marcsekz/radartof/hardware/portenta-shared-pins.PNG

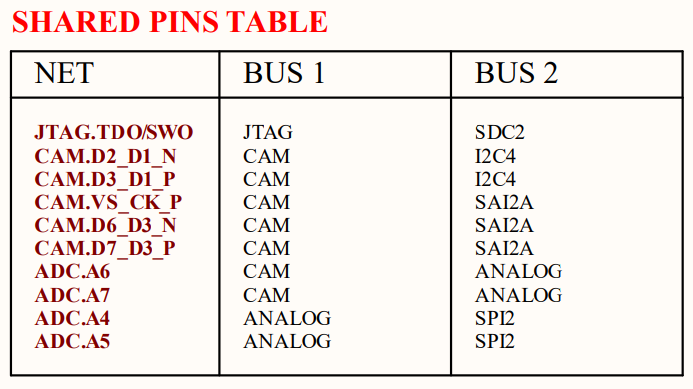
hardware/portenta-shared-pins.PNG
