marcsekz/radartof/hardware/Parts/1140084168/MicroSD.stp

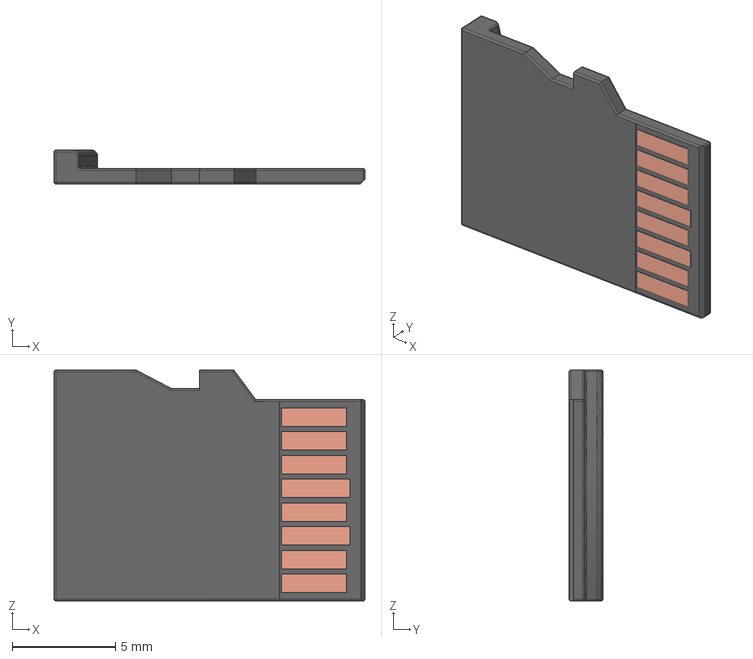
[picture p2: CAD file, 2023-04-24]
hardware/Parts/1140084168/MicroSD.stp
15.1 x 1.65 x 11.2 mm
