marcsekz/radartof/hardware/Parts/ASPI-4030S.STEP

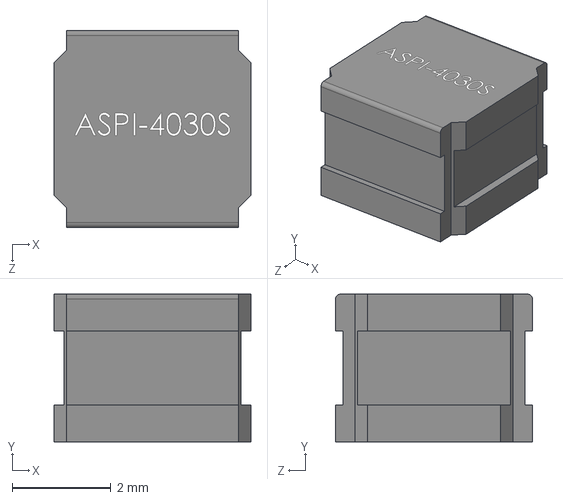
[picture p3: CAD file, 2023-04-24]
hardware/Parts/ASPI-4030S.STEP
4.00 x 3.00 x 4.00 mm
