marcsekz/radartof/hardware/Parts/Portenta/DF40HC(3.5)-80DS.stp

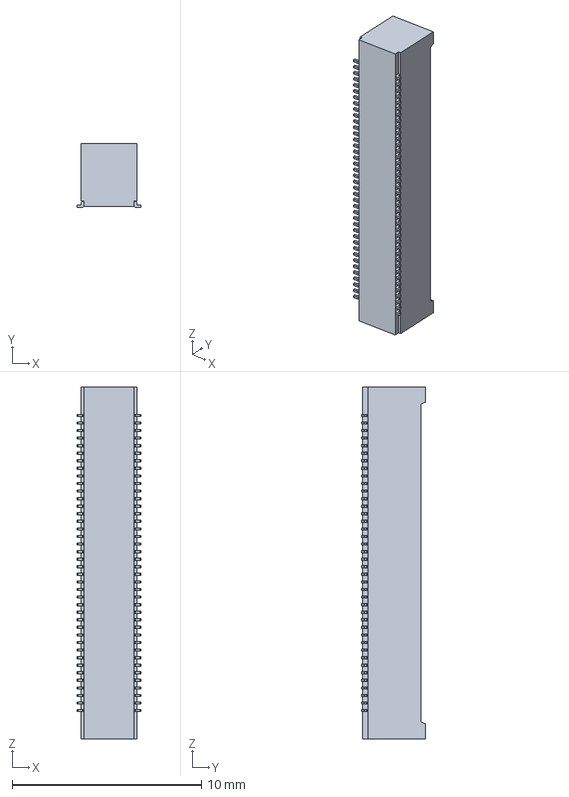
[picture p4: CAD file, 2023-04-14]
hardware/Parts/Portenta/DF40HC(3.5)-80DS.stp
3.38 x 3.40 x 18.6 mm
