marcsekz/radartof/hardware/Parts/PTS815-SJ/PTS815SJM250SMTRLFS.stp

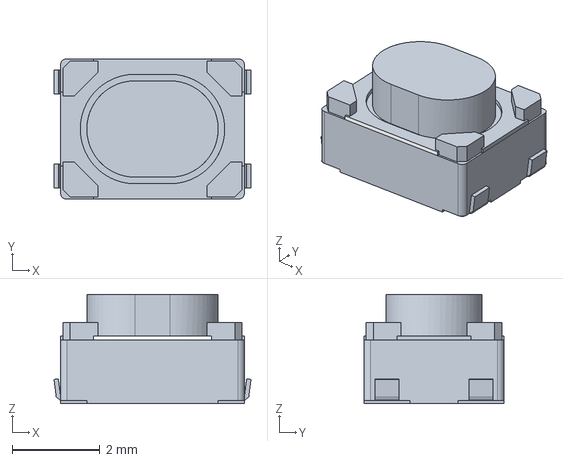
[picture p5: CAD file, 2023-04-24]
hardware/Parts/PTS815-SJ/PTS815SJM250SMTRLFS.stp
4.50 x 3.20 x 2.50 mm
