marcsekz/radartof/hardware/Parts/VL53L5CX/VL53L5CX_3D_model.step

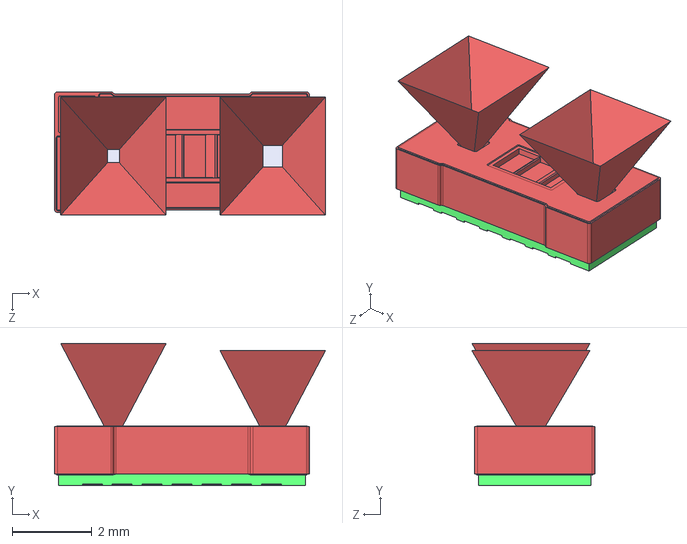
[picture p6: CAD file, 2023-04-24]
hardware/Parts/VL53L5CX/VL53L5CX_3D_model.step
6.81 x 3.57 x 3.10 mm
