marcsekz/radartof/hardware/Parts/PTS815-SJ/Download_STP_4341x30258x6 (rev1).stp

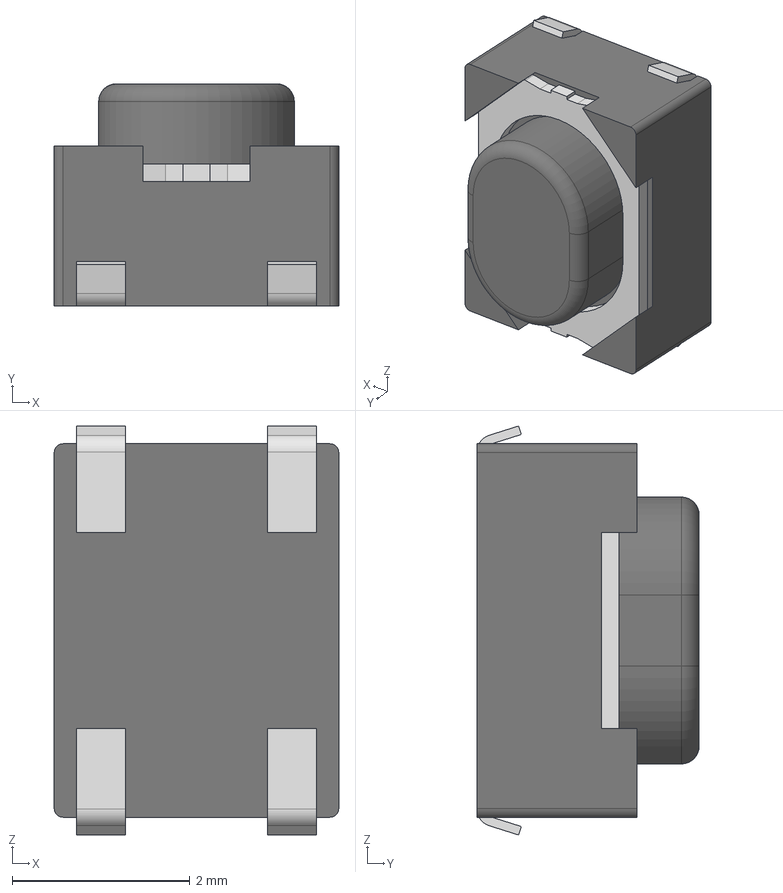
[picture p7: CAD file, 2023-04-24]
hardware/Parts/PTS815-SJ/Download_STP_4341x30258x6 (rev1).stp
3.20 x 2.50 x 4.60 mm
Frame
Cover
Stem
Terminal x 4
