marcsekz/radartof/hardware/Parts/216989-0001/2169890001.stp

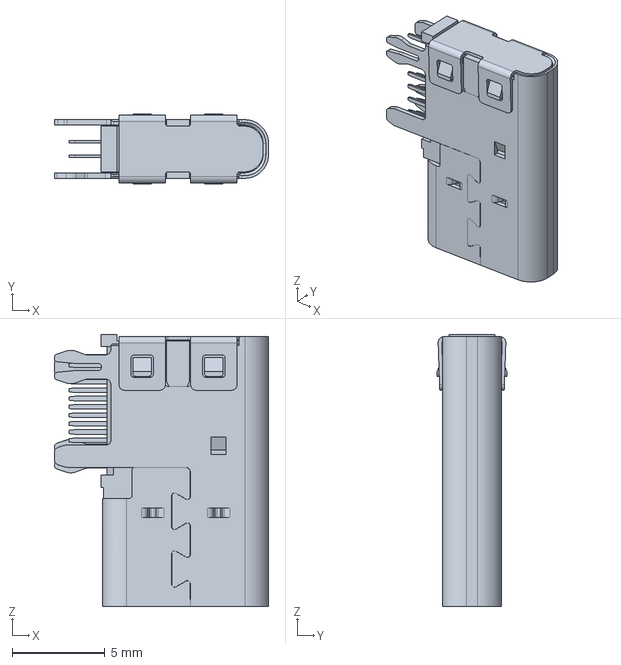
[picture p8: CAD file, 2023-04-24]
hardware/Parts/216989-0001/2169890001.stp
11.5 x 3.76 x 14.7 mm
