marcsekz/radartof/hardware/Parts/OV5640/5051102491.stp

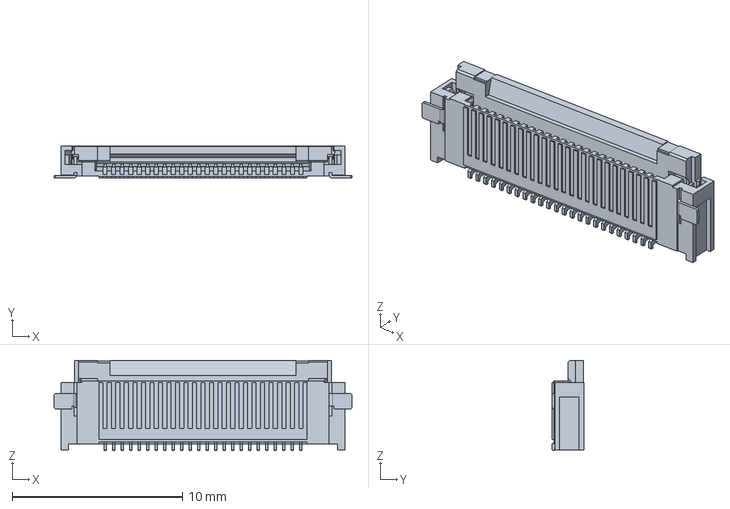
[picture p9: CAD file, 2023-04-24]
hardware/Parts/OV5640/5051102491.stp
17.5 x 1.90 x 5.30 mm
