marcsekz/radartof/hardware/Parts/1140084168/1140084168.step

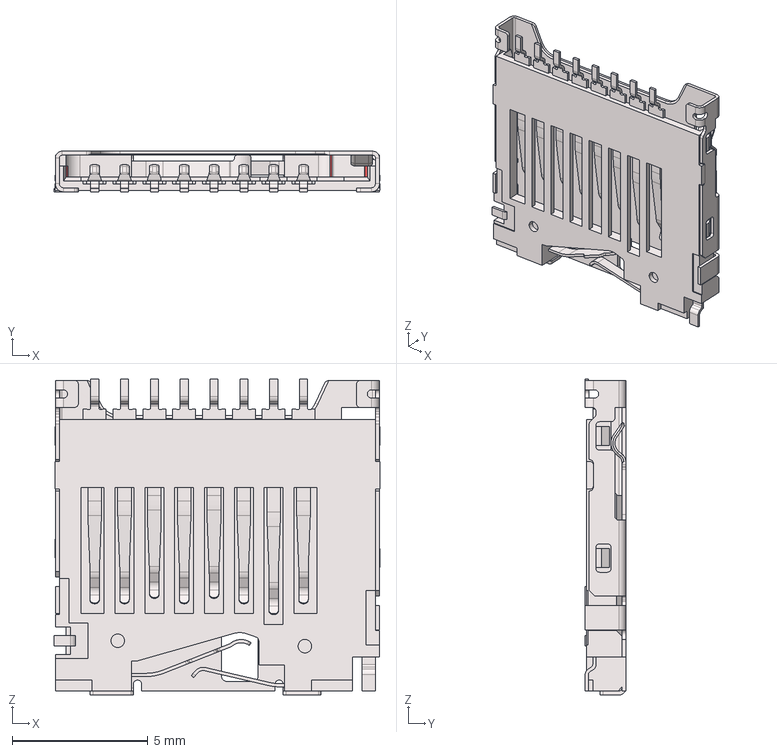
[picture p10: CAD file, 2023-04-24]
hardware/Parts/1140084168/1140084168.step
12.0 x 1.50 x 11.7 mm
