marcsekz/radartof/hardware/radartof-hardware.kicad_pcb.pdf

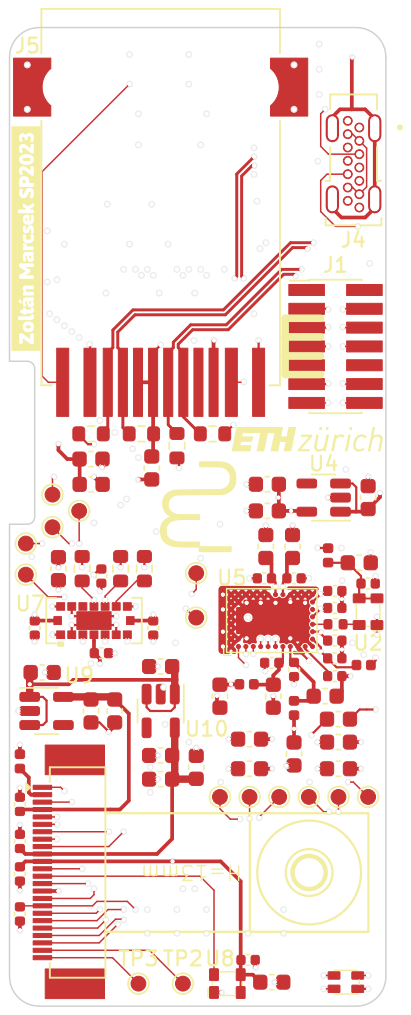
[picture p11: page 1]

Id: 1/1 Title: Heterogeneous radar, RGB, ToF sensor board

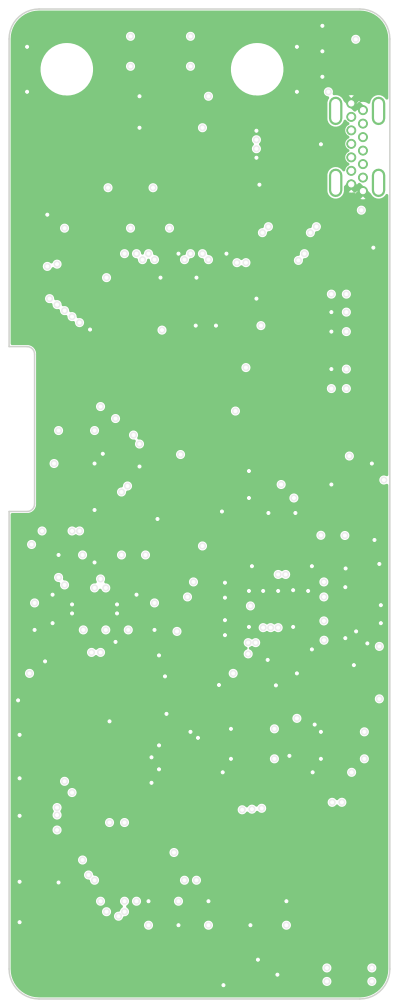
[picture p12: page 2]
D Date: 2023-04-26 KiCad; kicad-cli; 7.0.1-3b83917a11~172~ubuntu20.04.1 Size: A4; Rev:; File: radartof-hardware.kicad_pcb Sheet: Center for; Project-Based; Learning; þÿZoltán Marcsek

Id: 1/1 Title: Heterogeneous radar, RGB, ToF sensor board

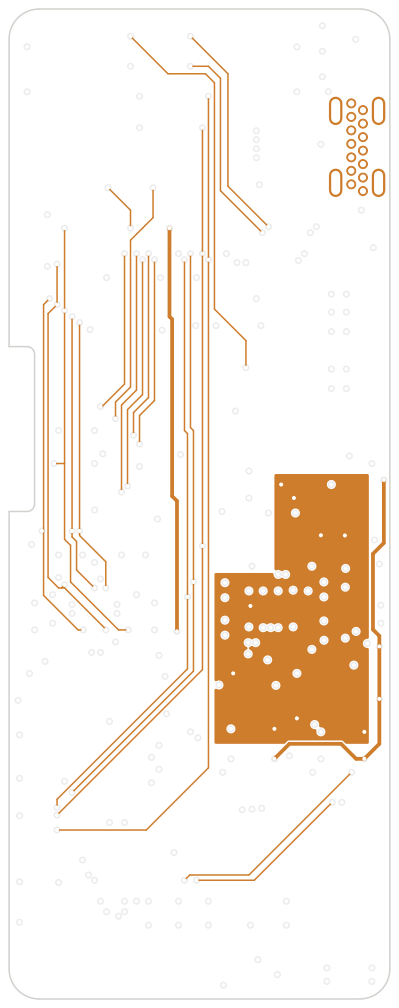
[picture p13: page 3]
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

Id: 1/1 Title: Heterogeneous radar, RGB, ToF sensor board

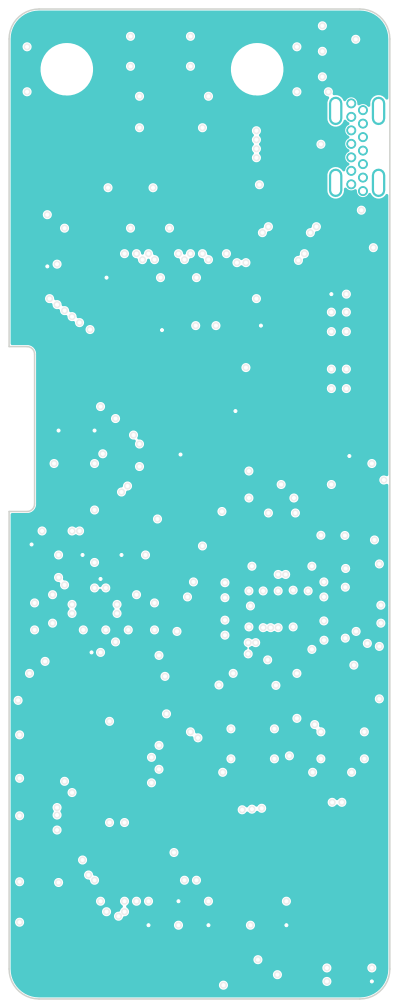
[picture p14: page 4]
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

Id: 1/1 Title: Heterogeneous radar, RGB, ToF sensor board

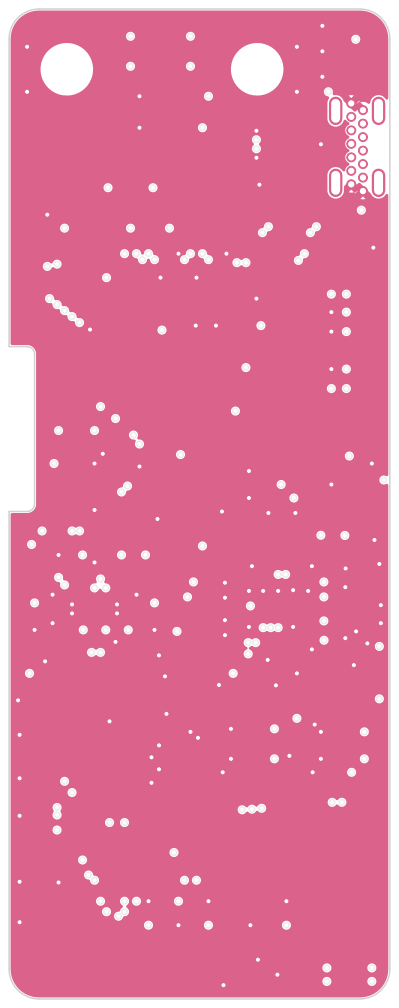
[picture p15: page 5]
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

Id: 1/1 Title: Heterogeneous radar, RGB, ToF sensor board

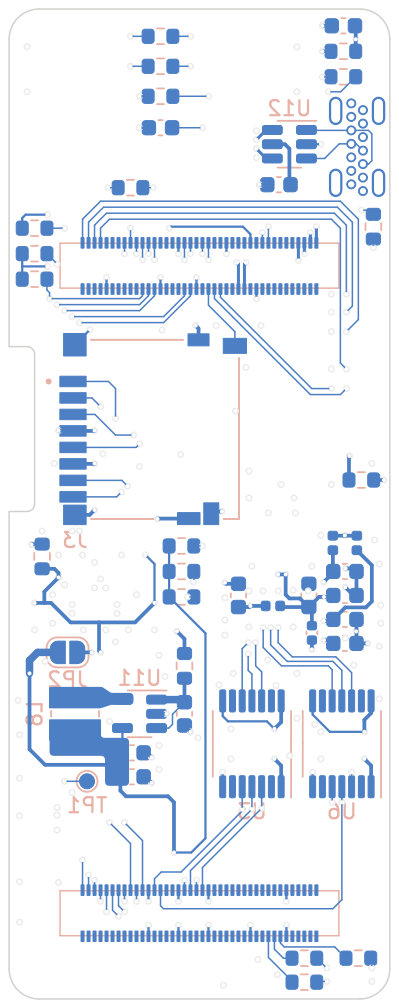
[picture p16: page 6]

Id: 1/1 Title: Heterogeneous radar, RGB, ToF sensor board
