marcsekz/radartof/hardware/radartof-hardware.pdf

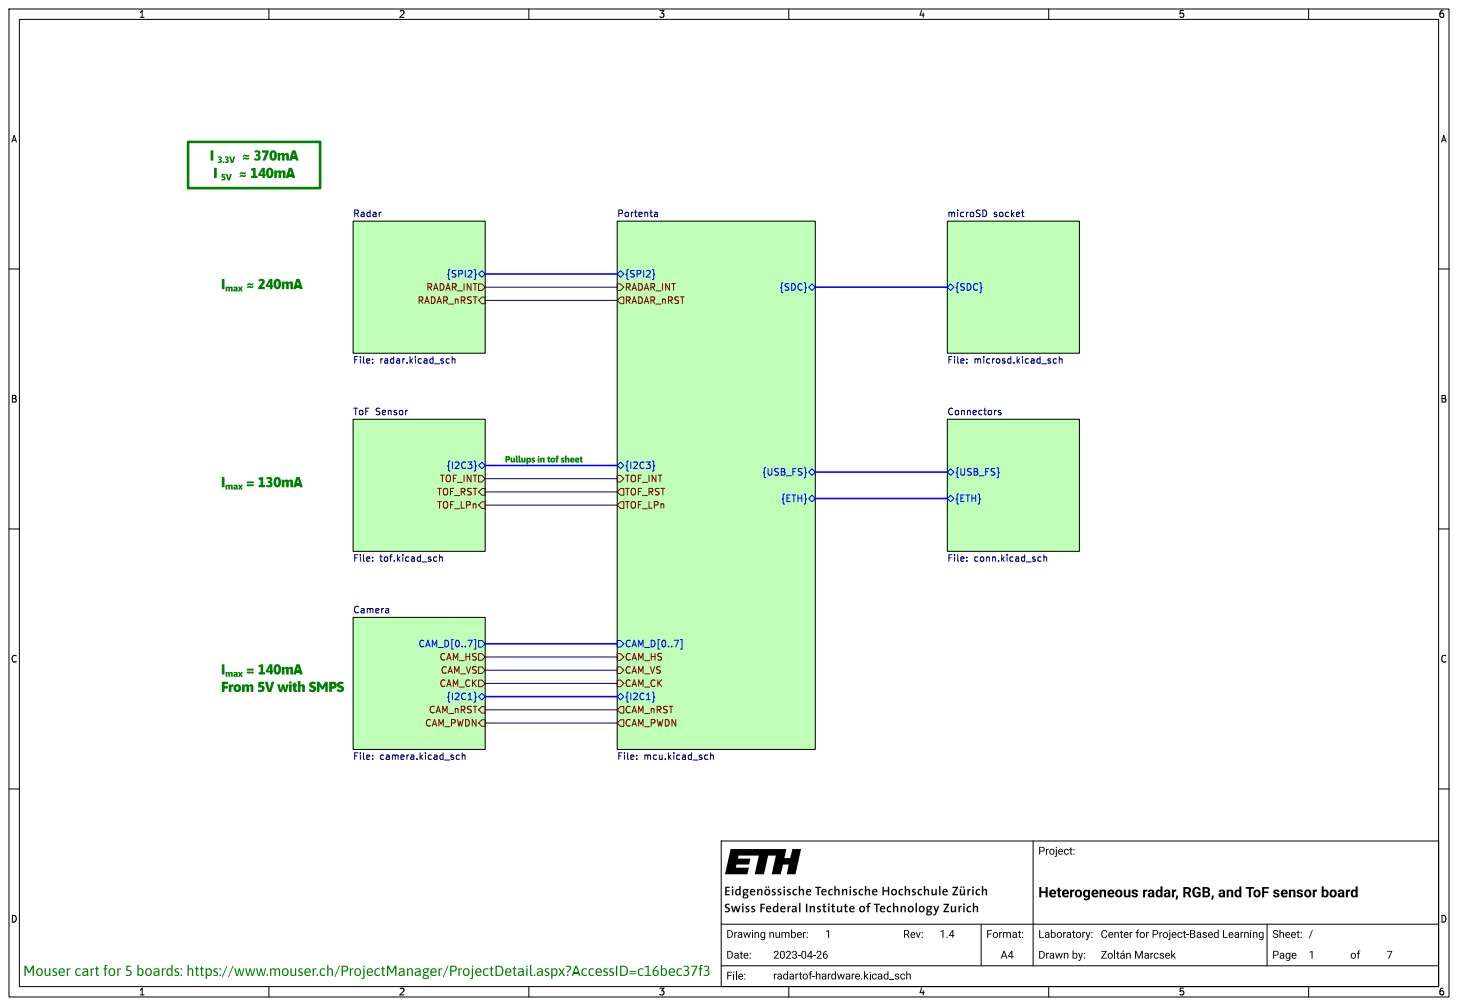
[picture p17: page 1]

{SDC} RADAR_nRST Portenta File: mcu.kicad_sch Pullupsin tof sheet I_{max} = 130mA

{SDC} microSD socket File: microsd.kicad_sch RADAR_INT
{SPI2} TOF_RST CAM_CK CAM_VS CAM_HS CAM_D[0..7] TOF_LPn CAM_PWDN

{I2C3} ToF Sensor File: tof.kicad_sch

Mouser cart for 5 boards:https://www.mouser.ch/ProjectManager/ProjectDetail.aspx?AccessID=c16bec37f3

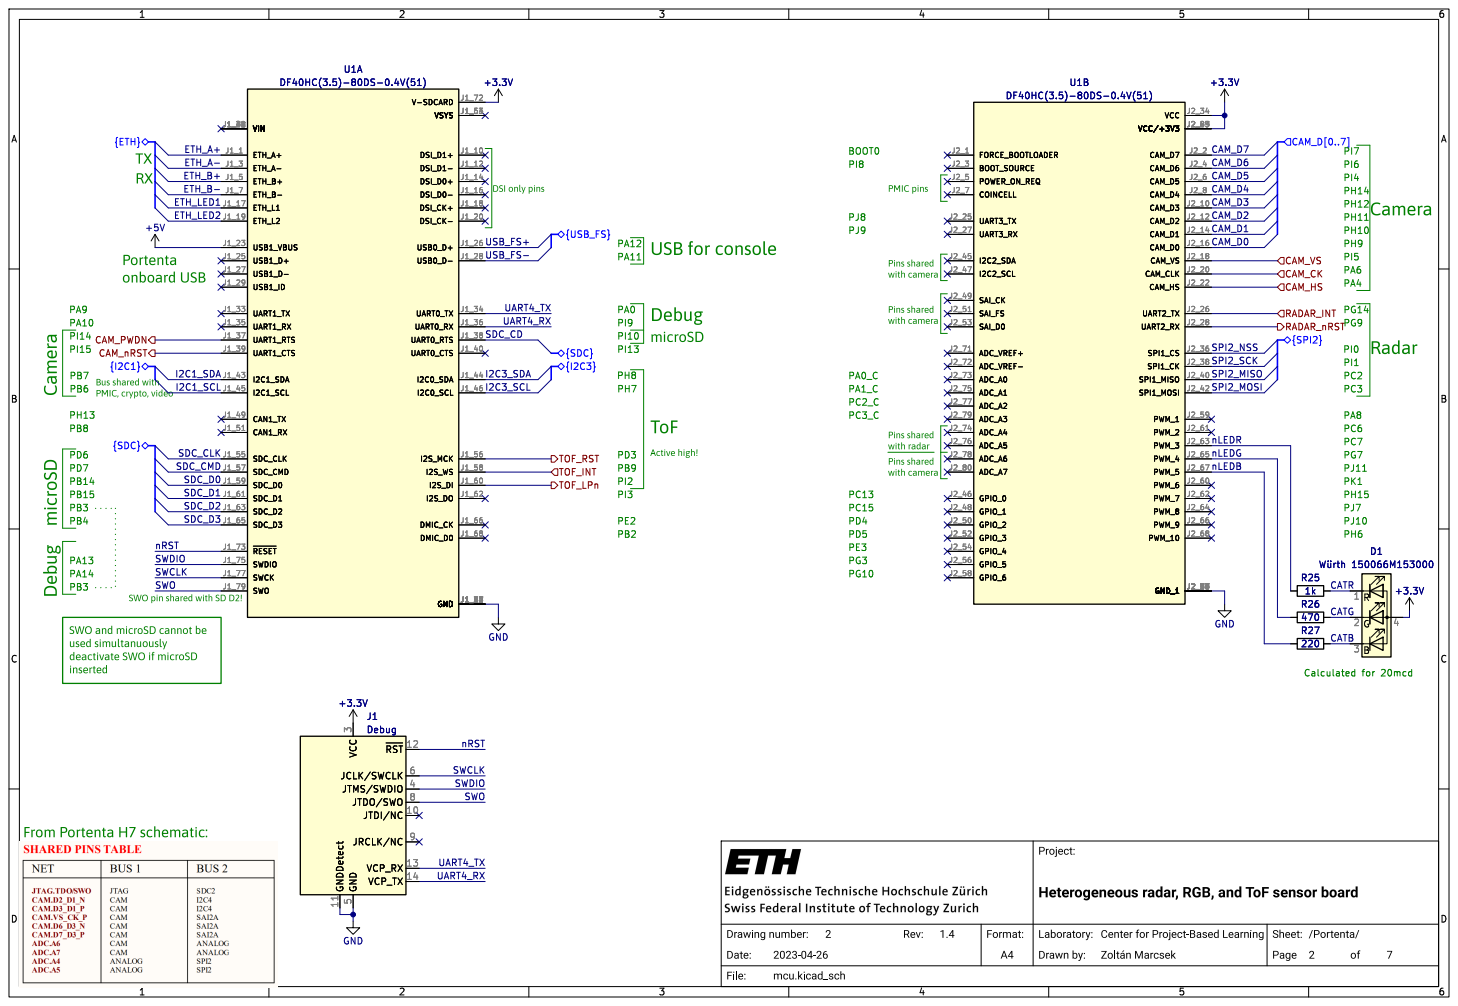
[picture p18: page 2]

used simultanuously deactivate SWOif microSD

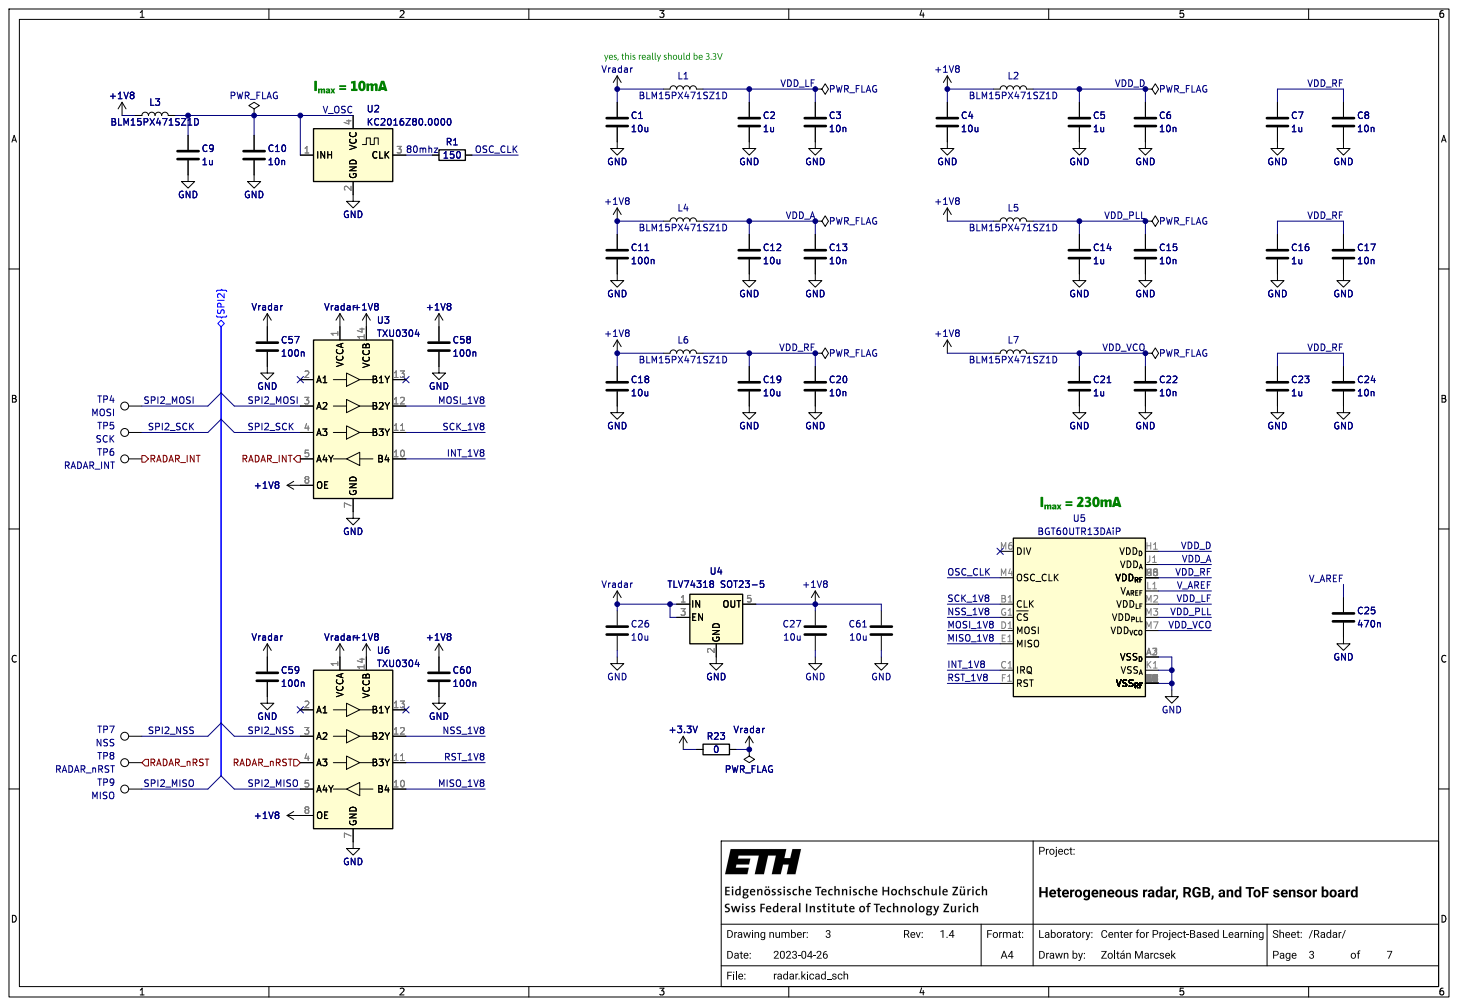
[picture p19: page 3]

yes,this really should be 3.3V

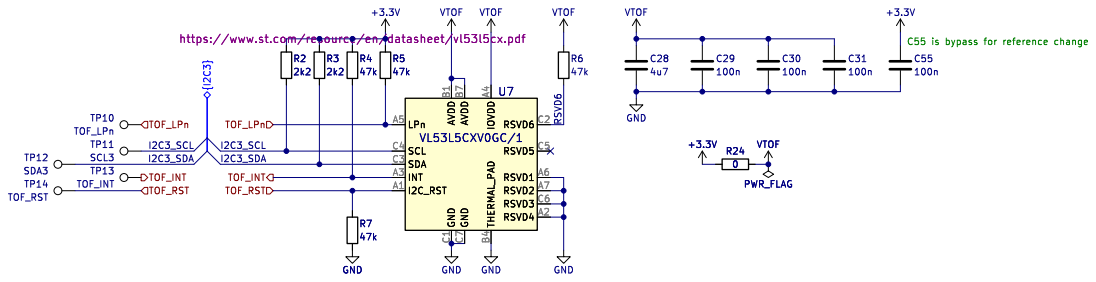
[picture p20: page 4]

https://www.st.com/resource/en/datasheet/vl53l5cx.pdf R2

https://www.st.com/resource/en/datasheet/vl53l5cx.pdf

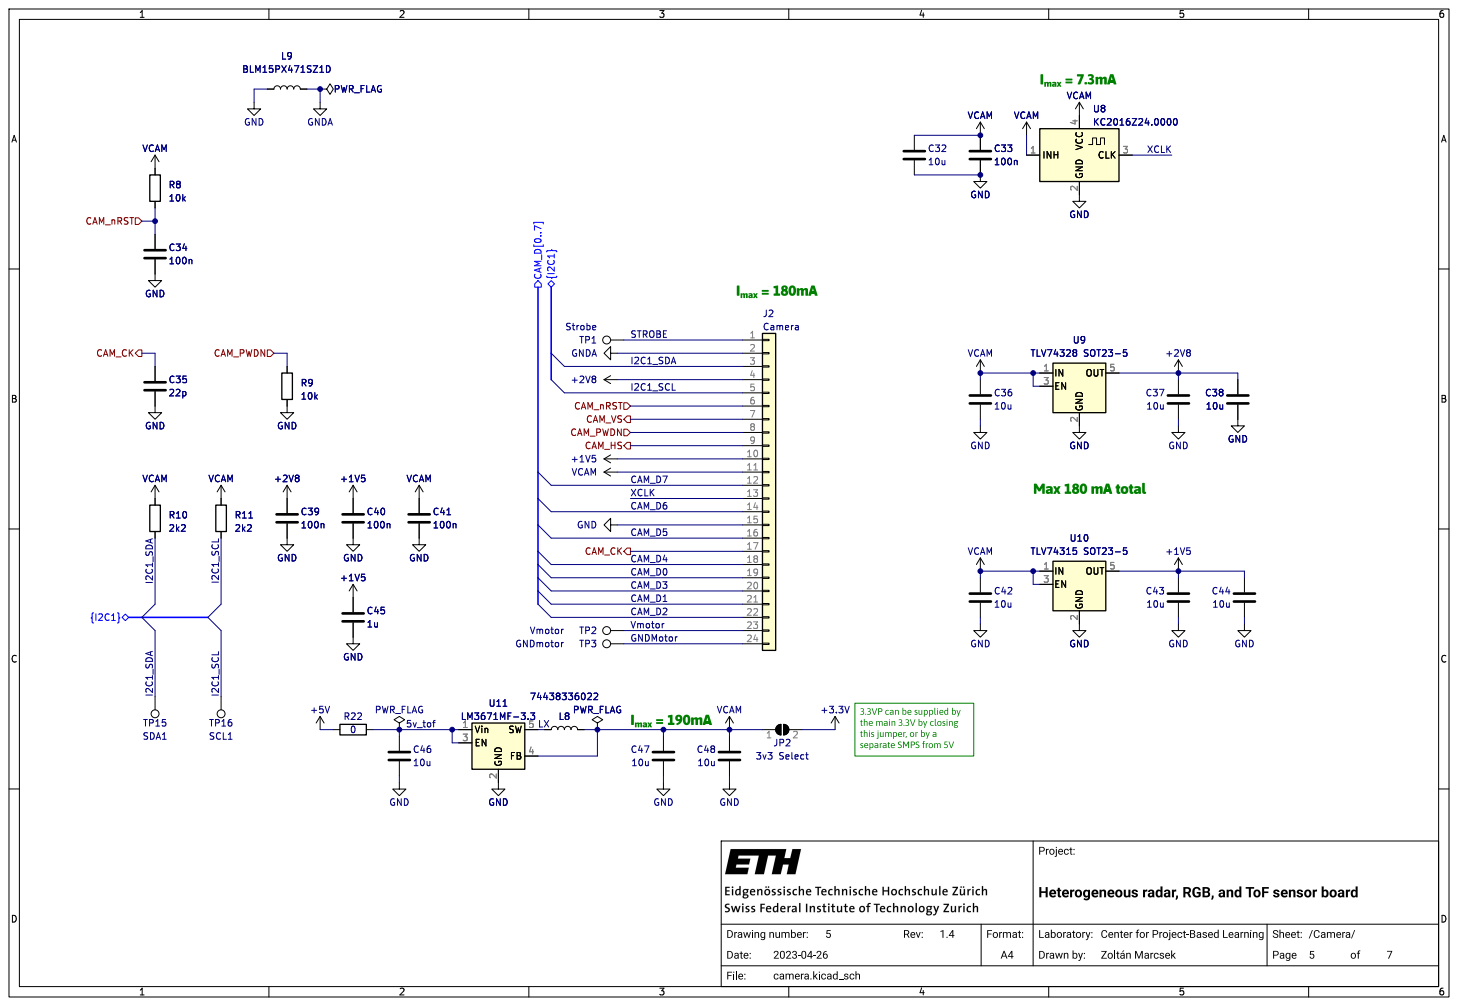
[picture p21: page 5]

3.3VPcan be supplied by
the main 3.3Vby closing
this jumper, or by a

2 EN 3 FB 4 SW 5 GND

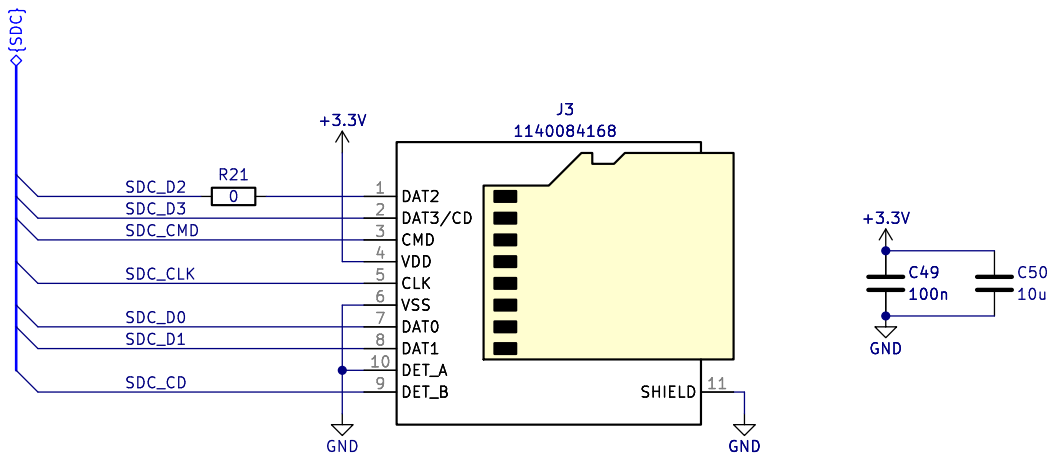
[picture p22: page 6]

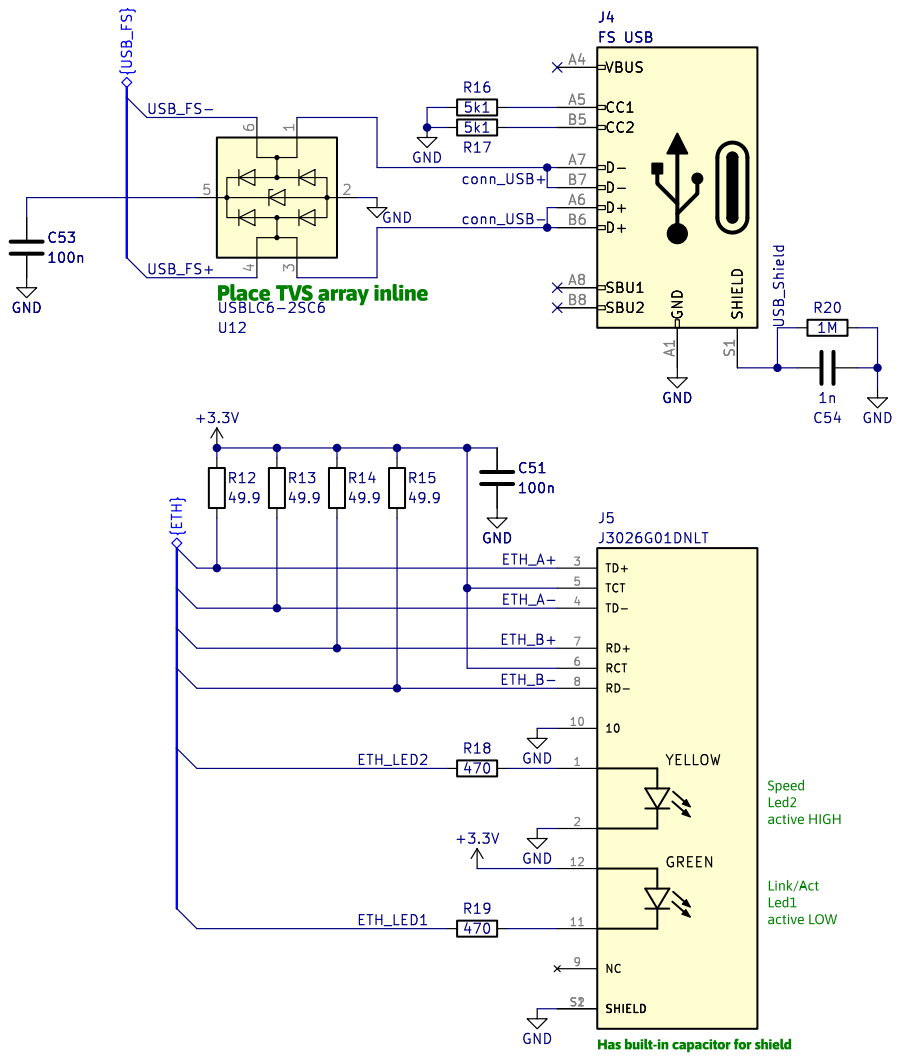
[picture p23: page 7]
