marcsekz/radartof/hardware/radartof-hardware.kicad_pcb

## KiCad design hardware/radartof-hardware.kicad_pcb (2023-06-26)

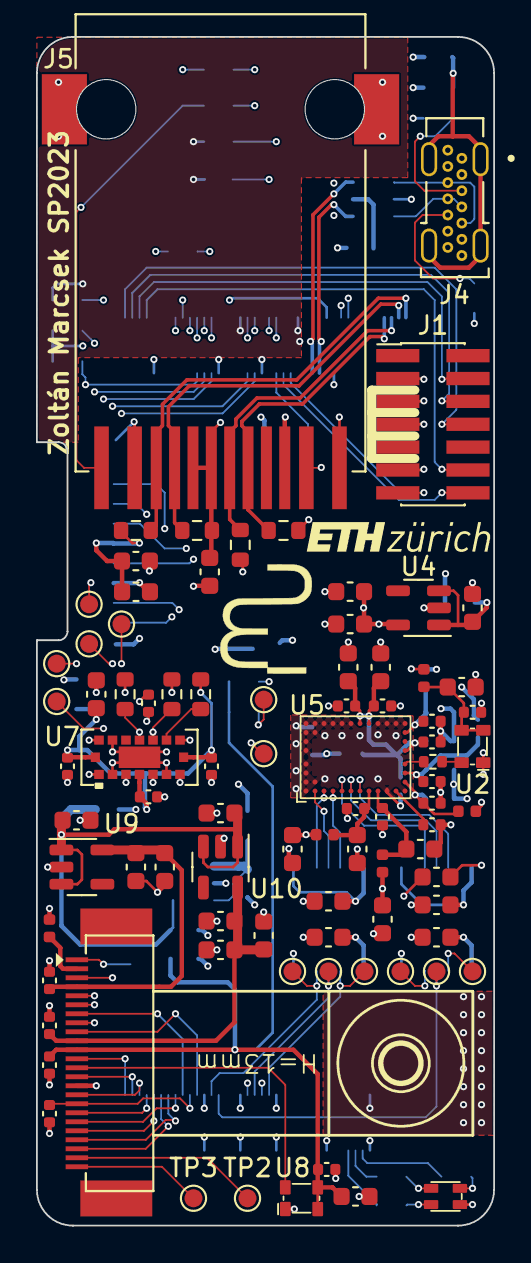
[picture p24: board radartof-hardware.kicad_pcb from above]

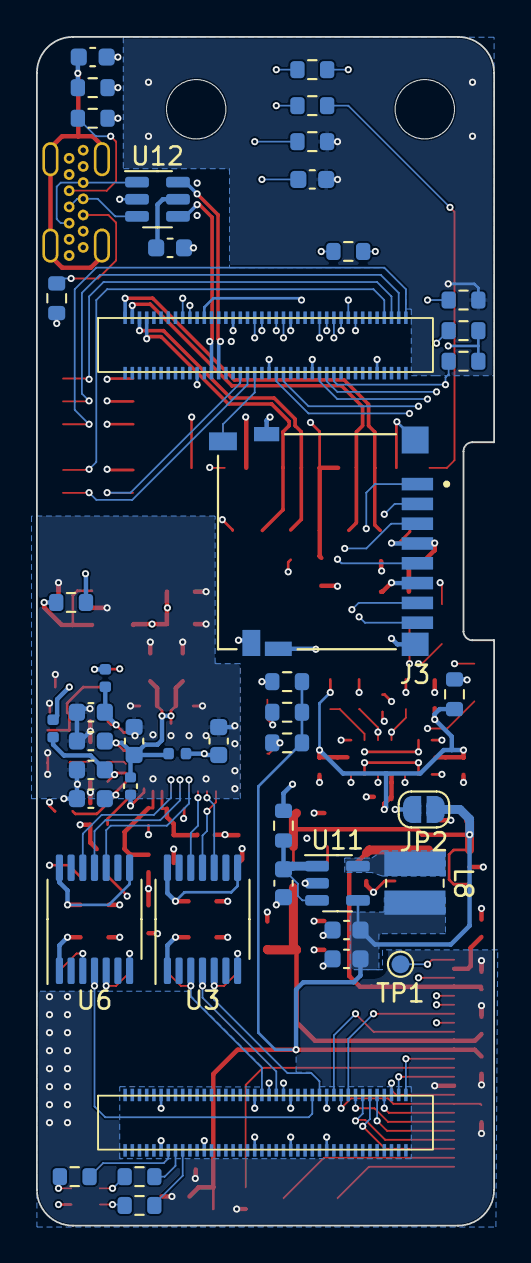
[picture p25: board radartof-hardware.kicad_pcb from below]

Board: 6 copper layers, 25.4 x 66.0 mm, 130 parts (44 on the bottom side), 95 nets.

Parts:
C1, C4, C12, C18, C19, C26, C27, C32, C36, C37, C38, C42, C43, C44, C46, C47, C48, C50, C61: 10u; C_0603_1608Metric
C2, C5, C7, C9, C14, C16, C21, C23, C45: 1u; C_0603_1608Metric
C3, C6, C8, C10, C13, C15, C17, C20, C22, C24: 10n; C_0402_1005Metric
C11, C34, C49, C51, C53, C57, C58, C59, C60: 100n; C_0603_1608Metric
C25: 470n; C_0402_1005Metric
C28: 4u7; C_0603_1608Metric
C29, C30, C31, C33, C39, C40, C41, C55: 100n; C_0402_1005Metric
C35: 22p; C_0402_1005Metric
C54: 1n; C_0603_1608Metric
D1: Würth 150066M153000; Würth_150066M153000
J1: Debug; PinHeader_2x07_P1.27mm_Vertical_SMD
J2: Camera; OV2640FSL
J3: 1140084168; AMPHENOL_1140084168
J4: FS USB; MOLEX_216989-0001
J5: J3026G01DNLT; PE_J3026G01DNLT
JP2: 3v3 Select; SolderJumper-2_P1.3mm_Open_RoundedPad1.0x1.5mm
L1, L2, L3, L4, L5, L6, L7, L9: BLM15PX471SZ1D; L_0402_1005Metric
L8: 74438336022; L_Wuerth_MAPI-3020
R1: 150; R_0402_1005Metric
R2, R3, R10, R11: 2k2; R_0603_1608Metric
R4, R5, R6, R7: 47k; R_0603_1608Metric
R8, R9: 10k; R_0603_1608Metric
R12, R13, R14, R15: 49.9; R_0603_1608Metric
R16, R17: 5k1; R_0603_1608Metric
R18, R19, R26: 470; R_0603_1608Metric
R20: 1M; R_0603_1608Metric
R21, R22, R23, R24: 0; R_0603_1608Metric
R25: 1k; R_0603_1608Metric
R27: 220; R_0603_1608Metric
TP1: Strobe; TestPoint_Pad_D1.0mm
TP2: Vmotor; TestPoint_Pad_D1.0mm
TP3: GNDmotor; TestPoint_Pad_D1.0mm
TP4: MOSI; TestPoint_Pad_D1.0mm
TP5: SCK; TestPoint_Pad_D1.0mm
TP6: RADAR_INT; TestPoint_Pad_D1.0mm
TP7: NSS; TestPoint_Pad_D1.0mm
TP8: RADAR_nRST; TestPoint_Pad_D1.0mm
TP9: MISO; TestPoint_Pad_D1.0mm
TP10: TOF_LPn; TestPoint_Pad_D1.0mm
TP11: SCL3; TestPoint_Pad_D1.0mm
TP12: SDA3; TestPoint_Pad_D1.0mm
TP13: TOF_INT; TestPoint_Pad_D1.0mm
TP14: TOF_RST; TestPoint_Pad_D1.0mm
TP15: SDA1; TestPoint_Pad_D1.0mm
TP16: SCL1; TestPoint_Pad_D1.0mm
U1: DF40HC(3.5)-80DS-0.4V(51); MODULE_ABX00042_NOSCREWS
U2: KC2016Z80.0000; KC2016Z
U3, U6: TXU0304; TSSOP-14_4.4x5mm_P0.65mm
U4: TLV74318 SOT23-5; SOT-23-5
U5: BGT60UTR13DAiP
U7: VL53L5CXV0GC/1; VL53L5CXV0GC&slash_1
U8: KC2016Z24.0000; KC2016Z
U9: TLV74328 SOT23-5; SOT-23-5
U10: TLV74315 SOT23-5; SOT-23-5
U11: LM3671MF-3.3; TSOT-23-5
U12: USBLC6-2SC6; SOT-23-6

Connections:
+1V5: C40.1, C43.1, C44.1, C45.1, J2.10, U10.5 (OUT)
+1V8: C4.1, C11.1, C18.1, C27.1, C58.1, C60.1, C61.1, L2.1, L3.1, L4.1, L5.1, L6.1, L7.1, U3.8 (OE), U3.14 (VCCB), U4.5 (OUT), U6.8 (OE), U6.14 (VCCB)
+2V8: C37.1, C38.1, C39.1, J2.4, U9.5 (OUT)
+3.3V: C49.1, C50.1, C51.1, C55.1, D1.4 (A), J1.3 (VCC), J3.4 (VDD), J5.5 (TCT), J5.6 (RCT), J5.12, JP2.2 (B), R2.1, R3.1, R4.1, R5.1, R12.1, R13.1, R14.1, R15.1, R23.1, R24.1, U1.J1_72 (V-SDCARD), U1.J2_23 (VCC/+3V3), U1.J2_34 (VCC), U1.J2_43 (VCC/+3V3), U1.J2_69 (VCC/+3V3)
+5V: R22.1, U1.J1_23 (USB1_VBUS)
/Camera/5v_tof: C46.1, R22.2, U11.1 (Vin), U11.3 (EN)
/Camera/CAM_CK: C35.1, J2.17, U1.J2_20 (CAM_CLK)
/Camera/CAM_D0: J2.19, U1.J2_16 (CAM_D0)
/Camera/CAM_D1: J2.21, U1.J2_14 (CAM_D1)
/Camera/CAM_D2: J2.22, U1.J2_12 (CAM_D2)
/Camera/CAM_D3: J2.20, U1.J2_10 (CAM_D3)
/Camera/CAM_D4: J2.18, U1.J2_8 (CAM_D4)
/Camera/CAM_D5: J2.16, U1.J2_6 (CAM_D5)
/Camera/CAM_D6: J2.14, U1.J2_4 (CAM_D6)
/Camera/CAM_D7: J2.12, U1.J2_2 (CAM_D7)
/Camera/CAM_HS: J2.9, U1.J2_22 (CAM_HS)
/Camera/CAM_PWDN: J2.8, R9.1, U1.J1_37 (UART1_RTS)
/Camera/CAM_VS: J2.7, U1.J2_18 (CAM_VS)
/Camera/CAM_nRST: C34.1, J2.6, R8.2, U1.J1_39 (UART1_CTS)
/Camera/GNDMotor: J2.24, TP3.1
/Camera/I2C1_SCL: J2.5, R11.2, TP16.1, U1.J1_45 (I2C1_SCL)
/Camera/I2C1_SDA: J2.3, R10.2, TP15.1, U1.J1_43 (I2C1_SDA)
/Camera/LX: L8.1, U11.5 (SW)
/Camera/STROBE: J2.1, TP1.1
/Camera/Vmotor: J2.23, TP2.1
/Camera/XCLK: J2.13, U8.3 (CLK)
/Connectors/ETH_A+: J5.3 (TD+), R12.2, U1.J1_1 (ETH_A+)
/Connectors/ETH_A-: J5.4 (TD-), R13.2, U1.J1_3 (ETH_A-)
/Connectors/ETH_B+: J5.7 (RD+), R14.2, U1.J1_5 (ETH_B+)
/Connectors/ETH_B-: J5.8 (RD-), R15.2, U1.J1_7 (ETH_B-)
/Connectors/ETH_LED1: R19.1, U1.J1_17 (ETH_L1)
/Connectors/ETH_LED2: R18.1, U1.J1_19 (ETH_L2)
/Connectors/USB_FS+: U1.J1_26 (USB0_D+), U12.4 (I/O2)
/Connectors/USB_FS-: U1.J1_28 (USB0_D-), U12.6 (I/O1)
/Connectors/USB_Shield: C54.1, J4.S1 (SHIELD), R20.1
/Connectors/conn_USB+: J4.A7 (D-), J4.B7 (D-), U12.1 (I/O1)
/Connectors/conn_USB-: J4.A6 (D+), J4.B6 (D+), U12.3 (I/O2)
/Portenta/CATB: D1.3 (BK), R27.2
/Portenta/CATG: D1.2 (GK), R26.2
/Portenta/CATR: D1.1 (RK), R25.2
/Portenta/I2C3_SCL: R2.2, TP11.1, U1.J1_46 (I2C0_SCL), U7.C4 (SCL)
/Portenta/I2C3_SDA: R3.2, TP12.1, U1.J1_44 (I2C0_SDA), U7.C3 (SDA)
/Portenta/RADAR_INT: TP6.1, U1.J2_26 (UART2_TX), U3.5 (A4Y)
/Portenta/RADAR_nRST: TP8.1, U1.J2_28 (UART2_RX), U6.4 (A3)
/Portenta/SDC_CD: J3.9 (DET_B), U1.J1_38 (UART0_RTS)
/Portenta/SDC_CLK: J3.5 (CLK), U1.J1_55 (SDC_CLK)
/Portenta/SDC_CMD: J3.3 (CMD), U1.J1_57 (SDC_CMD)
/Portenta/SDC_D0: J3.7 (DAT0), U1.J1_59 (SDC_D0)
/Portenta/SDC_D1: J3.8 (DAT1), U1.J1_61 (SDC_D1)
/Portenta/SDC_D2: R21.1, U1.J1_63 (SDC_D2)
/Portenta/SDC_D3: J3.2 (DAT3/CD), U1.J1_65 (SDC_D3)
/Portenta/SPI2_MISO: TP9.1, U1.J2_40 (SPI1_MISO), U6.5 (A4Y)
/Portenta/SPI2_MOSI: TP4.1, U1.J2_42 (SPI1_MOSI), U3.3 (A2)
/Portenta/SPI2_NSS: TP7.1, U1.J2_36 (SPI1_CS), U6.3 (A2)
/Portenta/SPI2_SCK: TP5.1, U1.J2_38 (SPI1_CK), U3.4 (A3)
/Portenta/SWCLK: J1.6 (JCLK/SWCLK), U1.J1_77 (SWCK)
/Portenta/SWDIO: J1.4 (JTMS/SWDIO), U1.J1_75 (SWDIO)
/Portenta/SWO: J1.8 (JTDO/SWO), U1.J1_79 (SWO)
/Portenta/TOF_INT: R4.2, TP13.1, U1.J1_58 (I2S_WS), U7.A3 (INT)
/Portenta/TOF_LPn: R5.2, TP10.1, U1.J1_60 (I2S_DI), U7.A5 (LPn)
/Portenta/TOF_RST: R7.1, TP14.1, U1.J1_56 (I2S_MCK), U7.A1 (I2C_RST)
/Portenta/UART4_RX: J1.14 (VCP_TX), U1.J1_36 (UART0_RX)
/Portenta/UART4_TX: J1.13 (VCP_RX), U1.J1_34 (UART0_TX)
/Portenta/nLEDB: R27.1, U1.J2_67 (PWM_5)
/Portenta/nLEDG: R26.1, U1.J2_65 (PWM_4)
/Portenta/nLEDR: R25.1, U1.J2_63 (PWM_3)
/Portenta/nRST: J1.12 (~RST), U1.J1_73 (~RESET)
/Radar/80mhz: R1.1, U2.3 (CLK)
/Radar/INT_1V8: U3.10 (B4), U5.C1 (IRQ)
/Radar/MISO_1V8: U5.E1 (MISO), U6.10 (B4)
/Radar/MOSI_1V8: U3.12 (B2Y), U5.D1 (MOSI)
/Radar/NSS_1V8: U5.G1 (~CS), U6.12 (B2Y)
/Radar/OSC_CLK: R1.2, U5.M4 (OSC_CLK)
/Radar/RST_1V8: U5.F1 (RST), U6.11 (B3Y)
/Radar/SCK_1V8: U3.11 (B3Y), U5.B1 (CLK)
/Radar/VDD_A: C12.1, C13.1, L4.2, U5.J1 (VDD_{A})
/Radar/VDD_D: C5.1, C6.1, L2.2, U5.H1 (VDD_{D})
/Radar/VDD_LF: C2.1, C3.1, L1.2, U5.M2 (VDD_{LF})
/Radar/VDD_PLL: C14.1, C15.1, L5.2, U5.M3 (VDD_{PLL})
/Radar/VDD_RF: C7.1, C8.1, C16.1, C17.1, C19.1, C20.1, C23.1, C24.1, L6.2, U5.G8 (VDD_{RF}), U5.H8 (VDD_{RF}), U5.M5 (VDD_{RF})
/Radar/VDD_VCO: C21.1, C22.1, L7.2, U5.M7 (VDD_{VCO})
/Radar/V_AREF: C25.1, U5.L1 (V_{AREF})
/Radar/V_OSC: C9.1, C10.1, L3.2, U2.1 (INH), U2.4 (VCC)
/ToF Sensor/RSVD6: R6.2, U7.C2 (RSVD6)
GND: C1.2, C2.2, C3.2, C4.2, C5.2, C6.2, C7.2, C8.2, C9.2, C10.2, C11.2, C12.2, C13.2, C14.2, C15.2, C16.2, C17.2, C18.2, C19.2, C20.2, C21.2, C22.2, C23.2, C24.2, C25.2, C26.2, C27.2, C28.2, C29.2, C30.2, C31.2, C32.2, C33.2, C34.2, C35.2, C36.2, C37.2, C38.2, C39.2, C40.2, C41.2, C42.2, C43.2, C44.2, C45.2, C46.2, C47.2, C48.2, C49.2, C50.2, C51.2, C53.2, C54.2, C55.2, C57.2, C58.2, C59.2, C60.2, C61.2, J1.5 (GND), J1.7 (GND), J1.11 (GNDDetect), J2.15, J3.6 (VSS), J3.10 (DET_A), J3.11 (SHIELD), J4.A1 (GND), J4.A12 (GND), J4.B1 (GND), J4.B12 (GND), J5.2, J5.10, J5.S1 (SHIELD), J5.S2 (SHIELD), L9.1, R7.2, R9.2, R16.1, R17.1, R20.2, U1.J1_22 (GND), U1.J1_31 (GND), U1.J1_42 (GND), U1.J1_47 (GND), U1.J1_54 (GND), U1.J2_24 (GND_1), U1.J2_33 (GND_1), U1.J2_44 (GND_1), U1.J2_57 (GND_1), U1.J2_70 (GND_1), U2.2 (GND), U3.7 (GND), U4.2 (GND), U5.A1 (VSS_{RF}), U5.A2 (VSS_{D}), U5.A3 (VSS_{D}), U5.A4 (VSS_{RF}), U5.A5 (VSS_{RF}), U5.A6 (VSS_{RF}), U5.A7 (VSS_{RF}), U5.A8 (VSS_{RF}), U5.B2 (VSS_{RF}), U5.B7 (VSS_{RF}), U5.B8 (VSS_{RF}), U5.C8 (VSS_{RF}), U5.D8 (VSS_{RF}), U5.E8 (VSS_{RF}), U5.F8 (VSS_{RF}), U5.J8 (VSS_{RF}), U5.K1 (VSS_{A}), U5.K8 (VSS_{RF}), U5.L8 (VSS_{RF}), U5.M1 (VSS_{RF}), U5.M8 (VSS_{RF}), U6.7 (GND), U7.A2 (RSVD4), U7.A6 (RSVD1), U7.A7 (RSVD2), U7.B4 (THERMAL_PAD), U7.C1 (GND), U7.C6 (RSVD3), U7.C7 (GND), U8.2 (GND), U9.2 (GND), U10.2 (GND), U11.2 (GND), U12.2 (GND)
GNDA: J2.2, L9.2
unnamed: J3.1 (DAT2), R21.2
unnamed: J4.A5 (CC1), R16.2
unnamed: J4.B5 (CC2), R17.2
unnamed: J5.1, R18.2
unnamed: J5.11, R19.2
unnamed: C53.1, U12.5 (VBUS)
VCAM: C32.1, C33.1, C36.1, C41.1, C42.1, C47.1, C48.1, J2.11, JP2.1 (A), L8.2, R8.1, R10.1, R11.1, U8.1 (INH), U8.4 (VCC), U9.1 (IN), U9.3 (EN), U10.1 (IN), U10.3 (EN), U11.4 (FB)
VTOF: C28.1, C29.1, C30.1, C31.1, R6.1, R24.2, U7.A4 (IOVDD), U7.B1 (AVDD), U7.B7 (AVDD)
Vradar: C1.1, C26.1, C57.1, C59.1, L1.1, R23.2, U3.1 (VCCA), U4.1 (IN), U4.3 (EN), U6.1 (VCCA)
