marcsekz/radartof/firmware/CM4/Core/Src/main.c

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
/* Includes ------------------------------------------------------------------*/
#include "main.h"
#include "cmsis_os.h"

/* USER CODE BEGIN Includes */

#include "my_util.h"
#include "app_tof.h"
#include "custom_ranging_sensor.h"
#include "bgt60_stm32.h"

/* USER CODE END Includes */

/* USER CODE BEGIN PD */

#define UPDATE_FREQ 15
#define NEW_DATA_HSEM_ID 1
#define TOF_RESULT_ADDR 0x30010001ul
#define NEW_DATA_FLAG_ADDR 0x30010000ul

#ifndef HSEM_ID_0
#define HSEM_ID_0 (0U) /* HW semaphore 0*/
#endif

/* USER CODE END PD */


DCMI_HandleTypeDef hdcmi;

I2C_HandleTypeDef hi2c1;

QSPI_HandleTypeDef hqspi;

SD_HandleTypeDef hsd2;

SPI_HandleTypeDef hspi2;

TIM_HandleTypeDef htim15;

UART_HandleTypeDef huart4;

SDRAM_HandleTypeDef hsdram1;

uint32_t tof_buffer[64];

/* Definitions for defaultTask */
osThreadId_t defaultTaskHandle;
const osThreadAttr_t defaultTask_attributes = {
  .name = "defaultTask",
  .stack_size = 1024 * 4,
  .priority = (osPriority_t) osPriorityNormal,
};
/* Definitions for newData */
osTimerId_t newDataHandle;
const osTimerAttr_t newData_attributes = {
  .name = "newData"
};
/* USER CODE BEGIN PV */

struct bgt60_h hbgt60 = 
{
  .transceive = bgt60_stm32_transceive,
  .read_reg = bgt60_stm32_read_reg,
  .write_reg = bgt60_stm32_write_reg,
  .gpio_cs_en = bgt60_stm32_gpio_cs_en
};

RANGING_SENSOR_Result_t TOF_Result;

/* USER CODE END PV */

static void MPU_Config(void);
static void MX_GPIO_Init(void);
static void MX_FMC_Init(void);
static void MX_QUADSPI_Init(void);
static void MX_SDMMC2_SD_Init(void);
static void MX_SPI2_Init(void);
static void MX_I2C1_Init(void);
static void MX_DCMI_Init(void);
static void MX_UART4_Init(void);
static void MX_TIM15_Init(void);
void StartDefaultTask(void *argument);
void cb_newData(void *argument);

/**
  * @brief  The application entry point.
  * @retval int
  */
int main(void)
{
  /* MPU Configuration--------------------------------------------------------*/
  MPU_Config();

/* USER CODE BEGIN Boot_Mode_Sequence_1 */
  /*HW semaphore Clock enable*/
  __HAL_RCC_HSEM_CLK_ENABLE();
  /* Activate HSEM notification for Cortex-M4*/
  HAL_HSEM_ActivateNotification(__HAL_HSEM_SEMID_TO_MASK(HSEM_ID_0));
  /*
  Domain D2 goes to STOP mode (Cortex-M4 in deep-sleep) waiting for Cortex-M7 to
  perform system initialization (system clock config, external memory configuration.. )
  */
  HAL_PWREx_ClearPendingEvent();
  HAL_PWREx_EnterSTOPMode(PWR_MAINREGULATOR_ON, PWR_STOPENTRY_WFE, PWR_D2_DOMAIN);
  /* Clear HSEM flag */
  __HAL_HSEM_CLEAR_FLAG(__HAL_HSEM_SEMID_TO_MASK(HSEM_ID_0));

/* USER CODE END Boot_Mode_Sequence_1 */
  /* MCU Configuration--------------------------------------------------------*/

  /* Reset of all peripherals, Initializes the Flash interface and the Systick. */
  HAL_Init();

  /* Initialize all configured peripherals */
  MX_GPIO_Init();
  MX_FMC_Init();
  MX_QUADSPI_Init();
  MX_SPI2_Init();
  MX_I2C1_Init();
  MX_DCMI_Init();
  MX_UART4_Init();
  MX_TIM15_Init();
  /* USER CODE BEGIN 2 */
  BSP_I2C3_Init();
  MX_TOF_Init();

  Delay_us_Init(&htim15);

  /* USER CODE END 2 */

  /* Init scheduler */
  osKernelInitialize();

  /* USER CODE BEGIN RTOS_MUTEX */
  /* add mutexes, ... */
  /* USER CODE END RTOS_MUTEX */

  /* USER CODE BEGIN RTOS_SEMAPHORES */
  /* add semaphores, ... */
  /* USER CODE END RTOS_SEMAPHORES */

  /* Create the timer(s) */
  /* creation of newData */
  newDataHandle = osTimerNew(cb_newData, osTimerPeriodic, NULL, &newData_attributes);

  /* USER CODE BEGIN RTOS_TIMERS */
  /* start timers, add new ones, ... */
  /* USER CODE END RTOS_TIMERS */

  /* USER CODE BEGIN RTOS_QUEUES */
  /* add queues, ... */
  /* USER CODE END RTOS_QUEUES */

  /* Create the thread(s) */
  /* creation of defaultTask */
  defaultTaskHandle = osThreadNew(StartDefaultTask, NULL, &defaultTask_attributes);

  /* USER CODE BEGIN RTOS_THREADS */
  /* add threads, ... */
  /* USER CODE END RTOS_THREADS */

  /* USER CODE BEGIN RTOS_EVENTS */
  /* add events, ... */
  /* USER CODE END RTOS_EVENTS */

  /* Start scheduler */
  osKernelStart();
  /* We should never get here as control is now taken by the scheduler */
  /* Infinite loop */
  /* USER CODE BEGIN WHILE */
  Error_Handler();
  while (1)
  {
    /* USER CODE END WHILE */

    /* USER CODE BEGIN 3 */
    // MX_TOF_Process();

    // HAL_GPIO_TogglePin(LEDB_GPIO_Port, LEDB_Pin);
    // HAL_Delay(100);
  }
  /* USER CODE END 3 */
}

/**
  * @brief DCMI Initialization Function
  * @param None
  * @retval None
  */
static void MX_DCMI_Init(void)
{

  hdcmi.Instance = DCMI;
  hdcmi.Init.SynchroMode = DCMI_SYNCHRO_HARDWARE;
  hdcmi.Init.PCKPolarity = DCMI_PCKPOLARITY_RISING;
  hdcmi.Init.VSPolarity = DCMI_VSPOLARITY_LOW;
  hdcmi.Init.HSPolarity = DCMI_HSPOLARITY_LOW;
  hdcmi.Init.CaptureRate = DCMI_CR_ALL_FRAME;
  hdcmi.Init.ExtendedDataMode = DCMI_EXTEND_DATA_8B;
  hdcmi.Init.JPEGMode = DCMI_JPEG_DISABLE;
  hdcmi.Init.ByteSelectMode = DCMI_BSM_ALL;
  hdcmi.Init.ByteSelectStart = DCMI_OEBS_ODD;
  hdcmi.Init.LineSelectMode = DCMI_LSM_ALL;
  hdcmi.Init.LineSelectStart = DCMI_OELS_ODD;
  if (HAL_DCMI_Init(&hdcmi) != HAL_OK)
  {
    Error_Handler();
  }
}

/**
  * @brief I2C1 Initialization Function
  * @param None
  * @retval None
  */
static void MX_I2C1_Init(void)
{

  hi2c1.Instance = I2C1;
  hi2c1.Init.Timing = 0x10C0ECFF;
  hi2c1.Init.OwnAddress1 = 0;
  hi2c1.Init.AddressingMode = I2C_ADDRESSINGMODE_7BIT;
  hi2c1.Init.DualAddressMode = I2C_DUALADDRESS_DISABLE;
  hi2c1.Init.OwnAddress2 = 0;
  hi2c1.Init.OwnAddress2Masks = I2C_OA2_NOMASK;
  hi2c1.Init.GeneralCallMode = I2C_GENERALCALL_DISABLE;
  hi2c1.Init.NoStretchMode = I2C_NOSTRETCH_DISABLE;
  if (HAL_I2C_Init(&hi2c1) != HAL_OK)
  {
    Error_Handler();
  }

  /** Configure Analogue filter
  */
  if (HAL_I2CEx_ConfigAnalogFilter(&hi2c1, I2C_ANALOGFILTER_ENABLE) != HAL_OK)
  {
    Error_Handler();
  }

  /** Configure Digital filter
  */
  if (HAL_I2CEx_ConfigDigitalFilter(&hi2c1, 0) != HAL_OK)
  {
    Error_Handler();
  }
}

/**
  * @brief QUADSPI Initialization Function
  * @param None
  * @retval None
  */
static void MX_QUADSPI_Init(void)
{

  /* QUADSPI parameter configuration*/
  hqspi.Instance = QUADSPI;
  hqspi.Init.ClockPrescaler = 1;
  hqspi.Init.FifoThreshold = 1;
  hqspi.Init.SampleShifting = QSPI_SAMPLE_SHIFTING_NONE;
  hqspi.Init.FlashSize = 23;
  hqspi.Init.ChipSelectHighTime = QSPI_CS_HIGH_TIME_4_CYCLE;
  hqspi.Init.ClockMode = QSPI_CLOCK_MODE_0;
  hqspi.Init.FlashID = QSPI_FLASH_ID_1;
  hqspi.Init.DualFlash = QSPI_DUALFLASH_DISABLE;
  if (HAL_QSPI_Init(&hqspi) != HAL_OK)
  {
    Error_Handler();
  }
}

/**
  * @brief SDMMC2 Initialization Function
  * @param None
  * @retval None
  */
static void MX_SDMMC2_SD_Init(void)
{

  hsd2.Instance = SDMMC2;
  hsd2.Init.ClockEdge = SDMMC_CLOCK_EDGE_RISING;
  hsd2.Init.ClockPowerSave = SDMMC_CLOCK_POWER_SAVE_DISABLE;
  hsd2.Init.BusWide = SDMMC_BUS_WIDE_4B;
  hsd2.Init.HardwareFlowControl = SDMMC_HARDWARE_FLOW_CONTROL_DISABLE;
  hsd2.Init.ClockDiv = 1;
  if (HAL_SD_Init(&hsd2) != HAL_OK)
  {
    Error_Handler();
  }
}

/**
  * @brief SPI2 Initialization Function
  * @param None
  * @retval None
  */
static void MX_SPI2_Init(void)
{

  /* SPI2 parameter configuration*/
  hspi2.Instance = SPI2;
  hspi2.Init.Mode = SPI_MODE_MASTER;
  hspi2.Init.Direction = SPI_DIRECTION_2LINES;
  hspi2.Init.DataSize = SPI_DATASIZE_32BIT;
  hspi2.Init.CLKPolarity = SPI_POLARITY_LOW;
  hspi2.Init.CLKPhase = SPI_PHASE_1EDGE;
  hspi2.Init.NSS = SPI_NSS_SOFT;
  hspi2.Init.BaudRatePrescaler = SPI_BAUDRATEPRESCALER_16;
  hspi2.Init.FirstBit = SPI_FIRSTBIT_MSB;
  hspi2.Init.TIMode = SPI_TIMODE_DISABLE;
  hspi2.Init.CRCCalculation = SPI_CRCCALCULATION_DISABLE;
  hspi2.Init.CRCPolynomial = 0x0;
  hspi2.Init.NSSPMode = SPI_NSS_PULSE_ENABLE;
  hspi2.Init.NSSPolarity = SPI_NSS_POLARITY_LOW;
  hspi2.Init.FifoThreshold = SPI_FIFO_THRESHOLD_01DATA;
  hspi2.Init.TxCRCInitializationPattern = SPI_CRC_INITIALIZATION_ALL_ZERO_PATTERN;
  hspi2.Init.RxCRCInitializationPattern = SPI_CRC_INITIALIZATION_ALL_ZERO_PATTERN;
  hspi2.Init.MasterSSIdleness = SPI_MASTER_SS_IDLENESS_00CYCLE;
  hspi2.Init.MasterInterDataIdleness = SPI_MASTER_INTERDATA_IDLENESS_00CYCLE;
  hspi2.Init.MasterReceiverAutoSusp = SPI_MASTER_RX_AUTOSUSP_DISABLE;
  hspi2.Init.MasterKeepIOState = SPI_MASTER_KEEP_IO_STATE_DISABLE;
  hspi2.Init.IOSwap = SPI_IO_SWAP_DISABLE;
  if (HAL_SPI_Init(&hspi2) != HAL_OK)
  {
    Error_Handler();
  }
}

/**
  * @brief TIM15 Initialization Function
  * @param None
  * @retval None
  */
static void MX_TIM15_Init(void)
{

  TIM_ClockConfigTypeDef sClockSourceConfig = {0};
  TIM_MasterConfigTypeDef sMasterConfig = {0};

  htim15.Instance = TIM15;
  htim15.Init.Prescaler = 240-1;
  htim15.Init.CounterMode = TIM_COUNTERMODE_UP;
  htim15.Init.Period = 65535;
  htim15.Init.ClockDivision = TIM_CLOCKDIVISION_DIV1;
  htim15.Init.RepetitionCounter = 0;
  htim15.Init.AutoReloadPreload = TIM_AUTORELOAD_PRELOAD_DISABLE;
  if (HAL_TIM_Base_Init(&htim15) != HAL_OK)
  {
    Error_Handler();
  }
  sClockSourceConfig.ClockSource = TIM_CLOCKSOURCE_INTERNAL;
  if (HAL_TIM_ConfigClockSource(&htim15, &sClockSourceConfig) != HAL_OK)
  {
    Error_Handler();
  }
  sMasterConfig.MasterOutputTrigger = TIM_TRGO_RESET;
  sMasterConfig.MasterSlaveMode = TIM_MASTERSLAVEMODE_DISABLE;
  if (HAL_TIMEx_MasterConfigSynchronization(&htim15, &sMasterConfig) != HAL_OK)
  {
    Error_Handler();
  }
}

/**
  * @brief UART4 Initialization Function
  * @param None
  * @retval None
  */
static void MX_UART4_Init(void)
{

  huart4.Instance = UART4;
  huart4.Init.BaudRate = 115200;
  huart4.Init.WordLength = UART_WORDLENGTH_8B;
  huart4.Init.StopBits = UART_STOPBITS_1;
  huart4.Init.Parity = UART_PARITY_NONE;
  huart4.Init.Mode = UART_MODE_TX_RX;
  huart4.Init.HwFlowCtl = UART_HWCONTROL_NONE;
  huart4.Init.OverSampling = UART_OVERSAMPLING_16;
  huart4.Init.OneBitSampling = UART_ONE_BIT_SAMPLE_DISABLE;
  huart4.Init.ClockPrescaler = UART_PRESCALER_DIV1;
  huart4.AdvancedInit.AdvFeatureInit = UART_ADVFEATURE_SWAP_INIT;
  huart4.AdvancedInit.Swap = UART_ADVFEATURE_SWAP_ENABLE;
  if (HAL_UART_Init(&huart4) != HAL_OK)
  {
    Error_Handler();
  }
  if (HAL_UARTEx_SetTxFifoThreshold(&huart4, UART_TXFIFO_THRESHOLD_1_8) != HAL_OK)
  {
    Error_Handler();
  }
  if (HAL_UARTEx_SetRxFifoThreshold(&huart4, UART_RXFIFO_THRESHOLD_1_8) != HAL_OK)
  {
    Error_Handler();
  }
  if (HAL_UARTEx_DisableFifoMode(&huart4) != HAL_OK)
  {
    Error_Handler();
  }
}

/* FMC initialization function */
void MX_FMC_Init(void)
{

  FMC_SDRAM_TimingTypeDef SdramTiming = {0};

  /** Perform the SDRAM1 memory initialization sequence
  */
  hsdram1.Instance = FMC_SDRAM_DEVICE;
  /* hsdram1.Init */
  hsdram1.Init.SDBank = FMC_SDRAM_BANK1;
  hsdram1.Init.ColumnBitsNumber = FMC_SDRAM_COLUMN_BITS_NUM_8;
  hsdram1.Init.RowBitsNumber = FMC_SDRAM_ROW_BITS_NUM_12;
  hsdram1.Init.MemoryDataWidth = FMC_SDRAM_MEM_BUS_WIDTH_16;
  hsdram1.Init.InternalBankNumber = FMC_SDRAM_INTERN_BANKS_NUM_4;
  hsdram1.Init.CASLatency = FMC_SDRAM_CAS_LATENCY_3;
  hsdram1.Init.WriteProtection = FMC_SDRAM_WRITE_PROTECTION_DISABLE;
  hsdram1.Init.SDClockPeriod = FMC_SDRAM_CLOCK_PERIOD_2;
  hsdram1.Init.ReadBurst = FMC_SDRAM_RBURST_DISABLE;
  hsdram1.Init.ReadPipeDelay = FMC_SDRAM_RPIPE_DELAY_0;
  /* SdramTiming */
  SdramTiming.LoadToActiveDelay = 2;
  SdramTiming.ExitSelfRefreshDelay = 8;
  SdramTiming.SelfRefreshTime = 5;
  SdramTiming.RowCycleDelay = 8;
  SdramTiming.WriteRecoveryTime = 2;
  SdramTiming.RPDelay = 3;
  SdramTiming.RCDDelay = 3;

  if (HAL_SDRAM_Init(&hsdram1, &SdramTiming) != HAL_OK)
  {
    Error_Handler( );
  }

}

/**
  * @brief GPIO Initialization Function
  * @param None
  * @retval None
  */
static void MX_GPIO_Init(void)
{
  GPIO_InitTypeDef GPIO_InitStruct = {0};
  /* GPIO Ports Clock Enable */
  __HAL_RCC_GPIOI_CLK_ENABLE();
  __HAL_RCC_GPIOK_CLK_ENABLE();
  __HAL_RCC_GPIOG_CLK_ENABLE();
  __HAL_RCC_GPIOD_CLK_ENABLE();
  __HAL_RCC_GPIOH_CLK_ENABLE();
  __HAL_RCC_GPIOB_CLK_ENABLE();
  __HAL_RCC_GPIOA_CLK_ENABLE();
  __HAL_RCC_GPIOC_CLK_ENABLE();

  /*Configure GPIO pin Output Level */
  HAL_GPIO_WritePin(GPIOK, LEDR_Pin|LEDB_Pin, GPIO_PIN_SET);

  /*Configure GPIO pin Output Level */
  HAL_GPIO_WritePin(RADAR_nRST_GPIO_Port, RADAR_nRST_Pin, GPIO_PIN_RESET);

  /*Configure GPIO pin Output Level */
  HAL_GPIO_WritePin(SPI2_NSS_GPIO_Port, SPI2_NSS_Pin, GPIO_PIN_SET);

  /*Configure GPIO pin Output Level */
  HAL_GPIO_WritePin(TOF_RST_GPIO_Port, TOF_RST_Pin, GPIO_PIN_RESET);

  /*Configure GPIO pin Output Level */
  HAL_GPIO_WritePin(GPIOI, TOF_LPn_Pin|CAM_PWDN_Pin|CAM_nRST_Pin, GPIO_PIN_RESET);

  /*Configure GPIO pin Output Level */
  HAL_GPIO_WritePin(TOF_PWREN_GPIO_Port, TOF_PWREN_Pin, GPIO_PIN_RESET);

  /*Configure GPIO pins : LEDR_Pin LEDB_Pin */
  GPIO_InitStruct.Pin = LEDR_Pin|LEDB_Pin;
  GPIO_InitStruct.Mode = GPIO_MODE_OUTPUT_PP;
  GPIO_InitStruct.Pull = GPIO_NOPULL;
  GPIO_InitStruct.Speed = GPIO_SPEED_FREQ_LOW;
  HAL_GPIO_Init(GPIOK, &GPIO_InitStruct);

  /*Configure GPIO pin : RADAR_nRST_Pin */
  GPIO_InitStruct.Pin = RADAR_nRST_Pin;
  GPIO_InitStruct.Mode = GPIO_MODE_OUTPUT_PP;
  GPIO_InitStruct.Pull = GPIO_NOPULL;
  GPIO_InitStruct.Speed = GPIO_SPEED_FREQ_LOW;
  HAL_GPIO_Init(RADAR_nRST_GPIO_Port, &GPIO_InitStruct);

  /*Configure GPIO pin : SPI2_NSS_Pin */
  GPIO_InitStruct.Pin = SPI2_NSS_Pin;
  GPIO_InitStruct.Mode = GPIO_MODE_OUTPUT_PP;
  GPIO_InitStruct.Pull = GPIO_NOPULL;
  GPIO_InitStruct.Speed = GPIO_SPEED_FREQ_HIGH;
  HAL_GPIO_Init(SPI2_NSS_GPIO_Port, &GPIO_InitStruct);

  /*Configure GPIO pin : TOF_RST_Pin */
  GPIO_InitStruct.Pin = TOF_RST_Pin;
  GPIO_InitStruct.Mode = GPIO_MODE_OUTPUT_PP;
  GPIO_InitStruct.Pull = GPIO_NOPULL;
  GPIO_InitStruct.Speed = GPIO_SPEED_FREQ_LOW;
  HAL_GPIO_Init(TOF_RST_GPIO_Port, &GPIO_InitStruct);

  /*Configure GPIO pins : TOF_LPn_Pin CAM_PWDN_Pin CAM_nRST_Pin */
  GPIO_InitStruct.Pin = TOF_LPn_Pin|CAM_PWDN_Pin|CAM_nRST_Pin;
  GPIO_InitStruct.Mode = GPIO_MODE_OUTPUT_PP;
  GPIO_InitStruct.Pull = GPIO_NOPULL;
  GPIO_InitStruct.Speed = GPIO_SPEED_FREQ_LOW;
  HAL_GPIO_Init(GPIOI, &GPIO_InitStruct);

  /*Configure GPIO pin : TOF_INT_Pin */
  GPIO_InitStruct.Pin = TOF_INT_Pin;
  GPIO_InitStruct.Mode = GPIO_MODE_INPUT;
  GPIO_InitStruct.Pull = GPIO_NOPULL;
  HAL_GPIO_Init(TOF_INT_GPIO_Port, &GPIO_InitStruct);

  /*Configure GPIO pin : RADAR_INT_Pin */
  GPIO_InitStruct.Pin = RADAR_INT_Pin;
  GPIO_InitStruct.Mode = GPIO_MODE_INPUT;
  GPIO_InitStruct.Pull = GPIO_NOPULL;
  HAL_GPIO_Init(RADAR_INT_GPIO_Port, &GPIO_InitStruct);

  /*Configure GPIO pin : TOF_PWREN_Pin */
  GPIO_InitStruct.Pin = TOF_PWREN_Pin;
  GPIO_InitStruct.Mode = GPIO_MODE_OUTPUT_PP;
  GPIO_InitStruct.Pull = GPIO_NOPULL;
  GPIO_InitStruct.Speed = GPIO_SPEED_FREQ_LOW;
  HAL_GPIO_Init(TOF_PWREN_GPIO_Port, &GPIO_InitStruct);

  /*Configure GPIO pin : SDC_CD_Pin */
  GPIO_InitStruct.Pin = SDC_CD_Pin;
  GPIO_InitStruct.Mode = GPIO_MODE_INPUT;
  GPIO_InitStruct.Pull = GPIO_NOPULL;
  HAL_GPIO_Init(SDC_CD_GPIO_Port, &GPIO_InitStruct);

}

/* USER CODE BEGIN 4 */

int _write(int file, char *ptr, int len) {
    // static uint8_t rc = USBD_OK;

    // do {
    //     rc = CDC_Transmit_FS(ptr, len);
    // } while (USBD_BUSY == rc);

    // if (USBD_FAIL == rc) {
    //     /// NOTE: Should never reach here.
    //     /// TODO: Handle this error.
    //     return 0;
    // }

    HAL_UART_Transmit(&huart4, ptr, len, 100);
    return len;
}

/* USER CODE END 4 */

/* USER CODE BEGIN Header_StartDefaultTask */
/**
  * @brief  Function implementing the defaultTask thread.
  * @param  argument: Not used
  * @retval None
  */
/* USER CODE END Header_StartDefaultTask */
void StartDefaultTask(void *argument)
{
  /* USER CODE BEGIN 5 */
  osTimerStart(newDataHandle, configTICK_RATE_HZ / UPDATE_FREQ);

  /* Infinite loop */
  for(;;)
  {

    // HAL_GPIO_TogglePin(LEDB_GPIO_Port, LEDB_Pin);
    osDelay(100);
  }
  /* USER CODE END 5 */
}

/* cb_newData function */
void cb_newData(void *argument)
{
  /* USER CODE BEGIN cb_newData */

  HAL_HSEM_FastTake(NEW_DATA_HSEM_ID);
  HAL_GPIO_TogglePin(LEDB_GPIO_Port, LEDB_Pin);
  int32_t ret = CUSTOM_RANGING_SENSOR_GetDistance(0, &TOF_Result);

  memcpy((uint8_t*)TOF_RESULT_ADDR, &TOF_Result, sizeof(RANGING_SENSOR_Result_t));

  for (size_t i = 0; i < 64; i++)
  {
    tof_buffer[i] = TOF_Result.ZoneResult[i].Distance[0];
  }
  
  
  *(uint8_t*)NEW_DATA_FLAG_ADDR |= 0x01;
  HAL_HSEM_Release(NEW_DATA_HSEM_ID, 1);

  /* USER CODE END cb_newData */
}

/* MPU Configuration */

void MPU_Config(void)
{
  MPU_Region_InitTypeDef MPU_InitStruct = {0};

  /* Disables the MPU */
  HAL_MPU_Disable();

  /** Initializes and configures the Region and the memory to be protected
  */
  MPU_InitStruct.Enable = MPU_REGION_ENABLE;
  MPU_InitStruct.Number = MPU_REGION_NUMBER0;
  MPU_InitStruct.BaseAddress = 0x30000000;
  MPU_InitStruct.Size = MPU_REGION_SIZE_128KB;
  MPU_InitStruct.SubRegionDisable = 0x0;
  MPU_InitStruct.TypeExtField = MPU_TEX_LEVEL0;
  MPU_InitStruct.AccessPermission = MPU_REGION_FULL_ACCESS;
  MPU_InitStruct.DisableExec = MPU_INSTRUCTION_ACCESS_DISABLE;
  MPU_InitStruct.IsShareable = MPU_ACCESS_NOT_SHAREABLE;
  MPU_InitStruct.IsCacheable = MPU_ACCESS_NOT_CACHEABLE;
  MPU_InitStruct.IsBufferable = MPU_ACCESS_NOT_BUFFERABLE;

  HAL_MPU_ConfigRegion(&MPU_InitStruct);
  /* Enables the MPU */
  HAL_MPU_Enable(MPU_PRIVILEGED_DEFAULT);

}

/**
  * @brief  Period elapsed callback in non blocking mode
  * @note   This function is called  when TIM14 interrupt took place, inside
  * HAL_TIM_IRQHandler(). It makes a direct call to HAL_IncTick() to increment
  * a global variable "uwTick" used as application time base.
  * @param  htim : TIM handle
  * @retval None
  */
void HAL_TIM_PeriodElapsedCallback(TIM_HandleTypeDef *htim)
{
  if (htim->Instance == TIM14) {
    HAL_IncTick();
  }
}

/**
  * @brief  This function is executed in case of error occurrence.
  * @retval None
  */
void Error_Handler(void)
{
  /* USER CODE BEGIN Error_Handler_Debug */
  /* User can add his own implementation to report the HAL error return state */
  __disable_irq();
  while (1)
  {
  }
  /* USER CODE END Error_Handler_Debug */
}

#ifdef  USE_FULL_ASSERT
/**
  * @brief  Reports the name of the source file and the source line number
  *         where the assert_param error has occurred.
  * @param  file: pointer to the source file name
  * @param  line: assert_param error line source number
  * @retval None
  */
void assert_failed(uint8_t *file, uint32_t line)
{
  /* USER CODE BEGIN 6 */
  /* User can add his own implementation to report the file name and line number,
     ex: printf("Wrong parameters value: file %s on line %d\r\n", file, line) */
  /* USER CODE END 6 */
}
#endif /* USE_FULL_ASSERT */
