marcsekz/radartof/firmware/radartof-fw-portenta.ioc

Mcu.UserName=STM32H747XIHx
PA0.Signal=UART4_TX
PA1.Signal=ETH_REF_CLK
PA11.Signal=USB_OTG_FS_DM
PA12.Signal=USB_OTG_FS_DP
PA2.Signal=ETH_MDIO
PA3.Signal=USB_OTG_HS_ULPI_D0
PA4.Signal=DCMI_HSYNC
PA5.Signal=USB_OTG_HS_ULPI_CK
PA6.Signal=DCMI_PIXCLK
PA7.Signal=ETH_CRS_DV
PA8.GPIO_Label=TOF_PWREN
PA8.Signal=GPIO_Output
PB0.Signal=USB_OTG_HS_ULPI_D1
PB1.Signal=USB_OTG_HS_ULPI_D2
PB10.Signal=USB_OTG_HS_ULPI_D3
PB11.Signal=USB_OTG_HS_ULPI_D4
PB12.Signal=USB_OTG_HS_ULPI_D5
PB13.Signal=USB_OTG_HS_ULPI_D6
PB14.Signal=SDMMC2_D0
PB15.Signal=SDMMC2_D1
PB5.Signal=USB_OTG_HS_ULPI_D7
PB6.Signal=I2C1_SCL
PB7.Signal=I2C1_SDA
PB9.GPIO_Label=TOF_INT
PB9.Signal=GPIO_Input
PC0.Signal=USB_OTG_HS_ULPI_STP
PC1.Signal=ETH_MDC
PC2.Signal=SPI2_MISO
PC3.Signal=SPI2_MOSI
PC4.Signal=ETH_RXD0
PC5.Signal=ETH_RXD1
PD0.Signal=FMC_D2_DA2
PD1.Signal=FMC_D3_DA3
PD10.Signal=FMC_D15_DA15
PD11.Signal=QUADSPI_BK1_IO0
PD12.Signal=QUADSPI_BK1_IO1
PD13.Signal=QUADSPI_BK1_IO3
PD14.Signal=FMC_D0_DA0
PD15.Signal=FMC_D1_DA1
PD3.GPIO_Label=TOF_RST
PD3.Signal=GPIO_Output
PD6.Signal=SDMMC2_CK
PD7.Signal=SDMMC2_CMD
PD8.Signal=FMC_D13_DA13
PD9.Signal=FMC_D14_DA14
PE0.Signal=FMC_NBL0
PE1.Signal=FMC_NBL1
PE10.Signal=FMC_D7_DA7
PE11.Signal=FMC_D8_DA8
PE12.Signal=FMC_D9_DA9
PE13.Signal=FMC_D10_DA10
PE14.Signal=FMC_D11_DA11
PE15.Signal=FMC_D12_DA12
PE7.Signal=FMC_D4_DA4
PE8.Signal=FMC_D5_DA5
PE9.Signal=FMC_D6_DA6
PF0.Signal=FMC_A0
PF1.Signal=FMC_A1
PF10.Signal=QUADSPI_CLK
PF11.Signal=FMC_SDNRAS
PF12.Signal=FMC_A6
PF13.Signal=FMC_A7
PF14.Signal=FMC_A8
PF15.Signal=FMC_A9
PF2.Signal=FMC_A2
PF3.Signal=FMC_A3
PF4.Signal=FMC_A4
PF5.Signal=FMC_A5
PF7.Signal=QUADSPI_BK1_IO2
PG0.Signal=FMC_A10
PG1.Signal=FMC_A11
PG11.Signal=ETH_TX_EN
PG12.Signal=ETH_TXD1
PG13.Signal=ETH_TXD0
PG14.GPIO_Label=RADAR_INT
PG14.Signal=GPIO_Input
PG15.Signal=FMC_SDNCAS
PG4.Signal=FMC_A14_BA0
PG5.Signal=FMC_A15_BA1
PG6.Signal=QUADSPI_BK1_NCS
PG8.Signal=FMC_SDCLK
PG9.GPIO_Label=RADAR_nRST
PG9.Signal=GPIO_Output
PH10.Signal=DCMI_D1
PH11.Signal=DCMI_D2
PH12.Signal=DCMI_D3
PH14.Signal=DCMI_D4
PH2.Signal=FMC_SDCKE0
PH3.Signal=FMC_SDNE0
PH4.Signal=USB_OTG_HS_ULPI_NXT
PH5.Signal=FMC_SDNWE
PH7.Signal=I2C3_SCL
PH8.Signal=I2C3_SDA
PH9.Signal=DCMI_D0
PI0.GPIO_Label=SPI2_NSS
PI0.Signal=GPIO_Output
PI1.Signal=SPI2_SCK
PI10.GPIO_Label=SDC_CD
PI10.Signal=GPIO_Input
PI11.Signal=USB_OTG_HS_ULPI_DIR
PI14.GPIO_Label=CAM_PWDN
PI14.Signal=GPIO_Output
PI15.GPIO_Label=CAM_nRST
PI15.Signal=GPIO_Output
PI2.GPIO_Label=TOF_LPn
PI2.Signal=GPIO_Output
PI4.Signal=DCMI_D5
PI5.Signal=DCMI_VSYNC
PI6.Signal=DCMI_D6
PI7.Signal=DCMI_D7
PI9.Signal=UART4_RX
PJ15.GPIO_Label=ETH_nRST
PJ15.Signal=GPIO_Output
PK5.GPIO_Label=LEDR
PK5.Signal=GPIO_Output
PK6.GPIO_Label=LEDG
PK6.Signal=GPIO_Output
PK7.GPIO_Label=LEDB
PK7.Signal=GPIO_Output
