marcsekz/radartof/firmware/CM4/Core/Inc/app_camera.h

#pragma once
#include "main.h"

#define CAMERA_FRAMEBUFFER 0x30000505 // FramBuffer after TOF result

/* Camera resolutions */
#define CAMERA_R160x120                 0U     /* QQVGA Resolution            */
#define CAMERA_R320x240                 1U     /* QVGA Resolution             */
#define CAMERA_R480x272                 2U     /* 480x272 Resolution          */
#define CAMERA_R640x480                 3U     /* VGA Resolution              */
#define CAMERA_R800x480                 4U     /* WVGA Resolution             */

/* Camera Pixel Format */
#define CAMERA_PF_RGB565                0U     /* Pixel Format RGB565         */
#define CAMERA_PF_RGB888                1U     /* Pixel Format RGB888         */
#define CAMERA_PF_YUV422                2U     /* Pixel Format YUV422         */

void Camera_Init(I2C_HandleTypeDef* hi2c, DCMI_HandleTypeDef* hdcmi, uint32_t resolution, uint32_t pixformat);
