marcsekz/radartof/(commit log)

2023-04-14 Add schematic pdf
    [radartof-hardware.kicad_sch]
2023-04-16 final-ish schematic
    [5051102491.stp, camera.kicad_sch, conn.kicad_sch, mcu.kicad_sch, radar.kicad_sch, radartof-hardware.kicad_pcb, radartof-hardware.kicad_sch, tof.kicad_sch]
2023-04-24 Finished routing
    [1140084168.step, 2169890001.stp, 5051102491.stp, ASPI-4030S.STEP, Download_STP_4341x30258x6 (rev1).stp, MicroSD.stp, PTS815SJM250SMTRLFS.stp, VL53L5CX_3D_model.step]
2023-04-24 Add PCB PDF export
    [radartof-hardware.kicad_pcb]
2023-04-25 Add testpoints, 0ohm, led, logos
    [camera.kicad_sch, conn.kicad_sch, mcu.kicad_sch, microsd.kicad_sch, radar.kicad_sch, radartof-hardware.kicad_pcb, radartof-hardware.kicad_sch, tof.kicad_sch]
2023-04-26 Final fixes, manufacturing
    [camera.kicad_sch, conn.kicad_sch, mcu.kicad_sch, microsd.kicad_sch, radar.kicad_sch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]
2023-05-08 Backup on-board firmware, I2C trace
2023-06-06 Ethernet working, add drivers for radar and camera
2023-06-14 still with half of the printing stuff
2023-06-26 Add dataset
    [dataset.csv, radartof-hardware.kicad_pcb]
2023-06-26 Fix radar footprint
    [radartof-hardware.kicad_pcb]
