marcsekz/radartof/(notices)

Notices in the files:
firmware/CM4/Core/Inc/custom_bus.h:
Copyright (c) 2023 STMicroelectronics.
All rights reserved.
This software is licensed under terms that can be found in the LICENSE file
hardware/Parts/PTS815-SJ/PTS815SJM250SMTRLFS.stp:
FILE_NAME( 'e:/temp/worker_57/temp/exporttempdir_5040_103_JhYAO/format_0/PTS815SJM250SMTRLFS.stp', '2022-01-14T14:14:18', ( 'License CC BY-ND 4.0' ), ( 'CADENAS' ), ' ', 'PARTsolutions', ' ' );
parts and their libraries:
Copyright 2021 Accelerated Designs. All rights reserved.
